marconicivitavecchia/2024-pedana-salto/ads1256.md

>[Torna all'indice](readme.md#fasi-progetto)

# Guida Collegamento ADS1256 con ESP32

## Hardware

### Modulo ADS1256
Il modulo utilizzato è un ADC (Analog to Digital Converter) ADS1256 con le seguenti caratteristiche:
- 24-bit di risoluzione
- 8 canali analogici
- Fino a 30kSPS di sampling rate
- Level shifter 5V-3.3V integrato
- Range di input analogico: ±5V (con alimentazione 5V)

### Collegamenti

#### Pin ESP32 → Modulo ADS1256
| ESP32 Pin | ADS1256 Pin | Descrizione |
|---|---|---|
| GPIO18 | SCLK | Clock SPI |
| GPIO23 | DIN | Data In (MOSI) |
| GPIO19 | DOUT | Data Out (MISO) |
| GPIO5* | CS | Chip Select |
| GPIO4* | DRDY | Data Ready |
| 3.3V | VDD | Alimentazione |
| GND | GND | Ground |

\* Questi pin possono essere cambiati con altri GPIO disponibili 

#### Pin Opzionali
- RESET: Non necessario, ha pull-up interno
- PDWN: Non necessario, ha pull-up interno

### Note Importanti
1. **Alimentazione**
   - Il modulo può essere alimentato sia a 5V che a 3.3V
   - Con alimentazione a 5V si ha il massimo range di input analogico (±5V)
   - Con alimentazione a 3.3V il range di input si riduce proporzionalmente

2. **Level Shifting**
   - Il modulo include già la conversione di livello 5V-3.3V
   - Non sono necessari convertitori di livello aggiuntivi
   - I segnali digitali sono già compatibili con la logica 3.3V dell'ESP32

3. **Ground**
   - Per le migliori prestazioni, mantenere separati i ground analogici e digitali
   - Collegare entrambi in un unico punto vicino all'alimentazione

4. **Input Analogici**
   - AIN0-AIN7: Accettano tensioni nel range ±5V (con VDD=5V)
   - Impedenza di ingresso: >1MΩ
   - Protezione da sovratensioni integrata

## Configurazione Software

### Inizializzazione SPI
```cpp
// Definizione pin
#define ADS1256_DRDY_PIN 4
#define ADS1256_CS_PIN   5

// Configurazione SPI
SPIClass *spi = new SPIClass(VSPI);
spi->begin(18, 19, 23, 5); // SCLK, MISO, MOSI, SS

// Configurazione pin
pinMode(ADS1256_DRDY_PIN, INPUT);
pinMode(ADS1256_CS_PIN, OUTPUT);
digitalWrite(ADS1256_CS_PIN, HIGH);
```

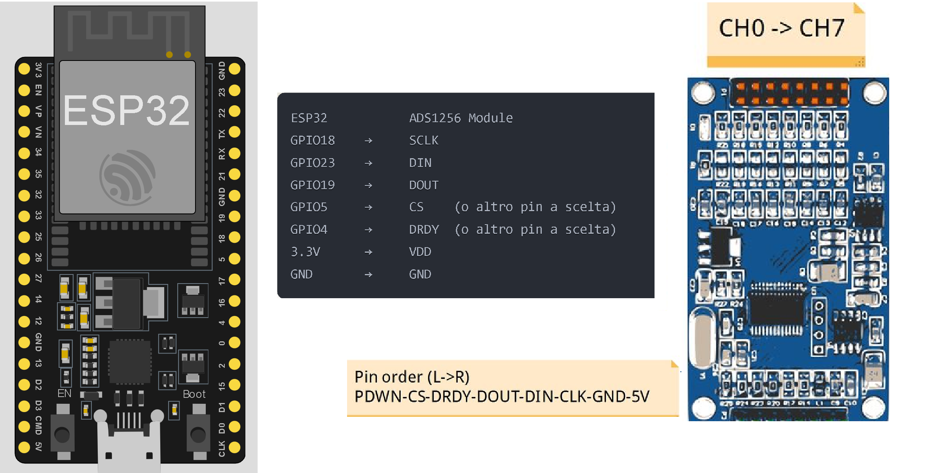
[picture p3: img/esp32pinout.png]


## Scheda Heltec WiFi_Kit_32_v3

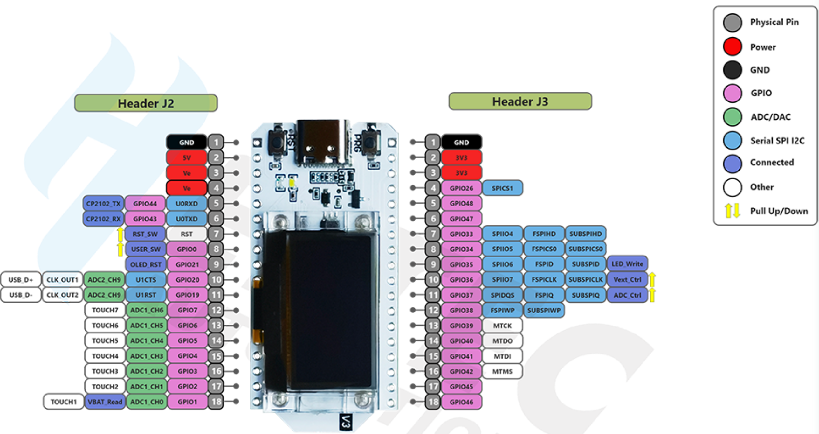
[picture p4: img/HTIT-WB32_V3.png]


### PINOUT ADS1256

| ADS1256 Pin | ESP32 Heltec V3 Pin | Funzione | Note |
|---|---|---|---|
| **Collegamenti SPI** ||||
| SCLK | GPIO47 (SPICLK_P)  | Clock SPI | *Collegamenti digitali* |
| DIN | GPIO35 (GPIO35) | Data Input (MOSI) | *Collegamenti digitali* |
| DOUT | GPIO36 (GPIO36) | Data Output (MISO) | *Collegamenti digitali* |
| CS | GPIO37 (GPIO37) | Chip Select | *Collegamenti digitali* |
| DRDY | GPIO38 (GPIO38) | Data Ready | *Collegamenti digitali* |
| **Collegamenti DAC -> ADC** ||||
| AIN6 | GPIO1 (DAC1) | Ingresso ADC+ canale diff. | *Segnale di test ADC* |
| AIN7 | GPIO2 (DAC2) | Ingresso ADC- canale diff. | *Segnale di test ADC* |
| **Alimentazioni** ||||
| AVDD | 3.3V (VDD_3V3) | Alimentazione Analogica | *Pin 2 o 3 di J3* |
| DVDD | 3.3V (VDD_3V3) | Alimentazione Digitale | *Pin 2 o 3 di J3* |
| PWDN | 3.3V (VDD_3V3) | Power Down (attivo basso) | *Pin 2 o 3 di J3* |
| **Masse** ||||
| AGND | GND centrale | Ground Analogico | *GND pad centrale vicino antenna* |
| DGND | GND (Pin 1 J2) | Ground Digitale | *Pin 1 del Header J2* |
| **Connessioni esterne** ||||
| AIN0 | - | Ingresso ADC+ canale diff. | *Connettore esterno doppino schermato* |
| AIN1 | - | Ingresso ADC- canale diff. | *Connettore esterno doppino schermato* |

Note aggiuntive:

- Il GND centrale (pad vicino antenna) è raccomandato per i segnali analogici poiché è più isolato dai disturbi digitali
- Il pin 1 di J2 è consigliato per i segnali digitali SPI dato che è più vicino ai pin di comunicazione
- Le alimentazioni 3.3V possono essere prese dai pin 2 o 3 del Header J3
- Si raccomanda di mantenere le piste di ground separate il più possibile sul PCB e unirle in un unico punto vicino all'alimentazione
- Aggiungere capacità di bypass tra AVDD-AGND e DVDD-DGND il più vicino possibile ai pin dell'ADS1256

### Pinout schermo OLED

| Pin Display | ESP32 Heltec V3 Pin | Funzione |
|---|---|---|
| CS | GPIO39 (MTCK) | Chip Select OLED |
| DC | GPIO40 (MTDO) | Data/Command |
| RST | GPIO21 (GPIO21) | Reset |
| D0/SCK | GPIO41 (MTDI) | Clock SPI |
| D1/MOSI | GPIO42 (MTMS) | Data Input |

Lo schermo OLED usa l'interfaccia SPI secondaria attraverso i pin MT** (JTAG), che sono stati riproposti per questo scopo.

Questo è separato dall'interfaccia SPI che abbiamo pianificato di usare per l'ADS1256, quindi non ci saranno conflitti tra i due dispositivi.

### Velocità SPI
- L'ADS1256 supporta clock SPI fino a 2MHz
- Consigliato iniziare con frequenze più basse (es. 1MHz) e aumentare se necessario
- La velocità può essere impostata con: `spi->beginTransaction(SPISettings(1000000, MSBFIRST, SPI_MODE1));`

## Troubleshooting
1. **Letture instabili**
   - Verificare la qualità dell'alimentazione
   - Controllare la connessione dei ground
   - Ridurre la velocità SPI

2. **Comunicazione non funzionante**
   - Verificare i collegamenti dei pin SPI
   - Controllare la tensione di alimentazione
   - Verificare che CS e DRDY funzionino correttamente

3. **Rumore nelle misure**
   - Utilizzare cavi schermati per gli input analogici
   - Separare i percorsi dei segnali analogici e digitali
   - Considerare l'uso di ferriti sui cavi di alimentazione

Il FW, completo di pagina web di interfaccia, è reperibile nella cartella src: https://github.com/marconicivitavecchia/2024-pedana-salto/tree/main/src

La libreria ```ADS1256_DMA.h``` in uso imposta già internamente sia le porte digitali che il BUS SPI secondo le pedinature sopra riportate per cui non è necessario eseguire la loro configurazione esplicita all'interno della funzione ```setup()```.

Sitografia:
- https://espressif-docs.readthedocs-hosted.com/projects/arduino-esp32/en/latest/api/timer.html
- https://claude.ai/chat/577f5692-3126-4db2-abea-41f3730c12e6

>[Torna all'indice](readme.md#fasi-progetto)
