marconicivitavecchia/2024-pedana-salto/img/ads1256_single_ended.png

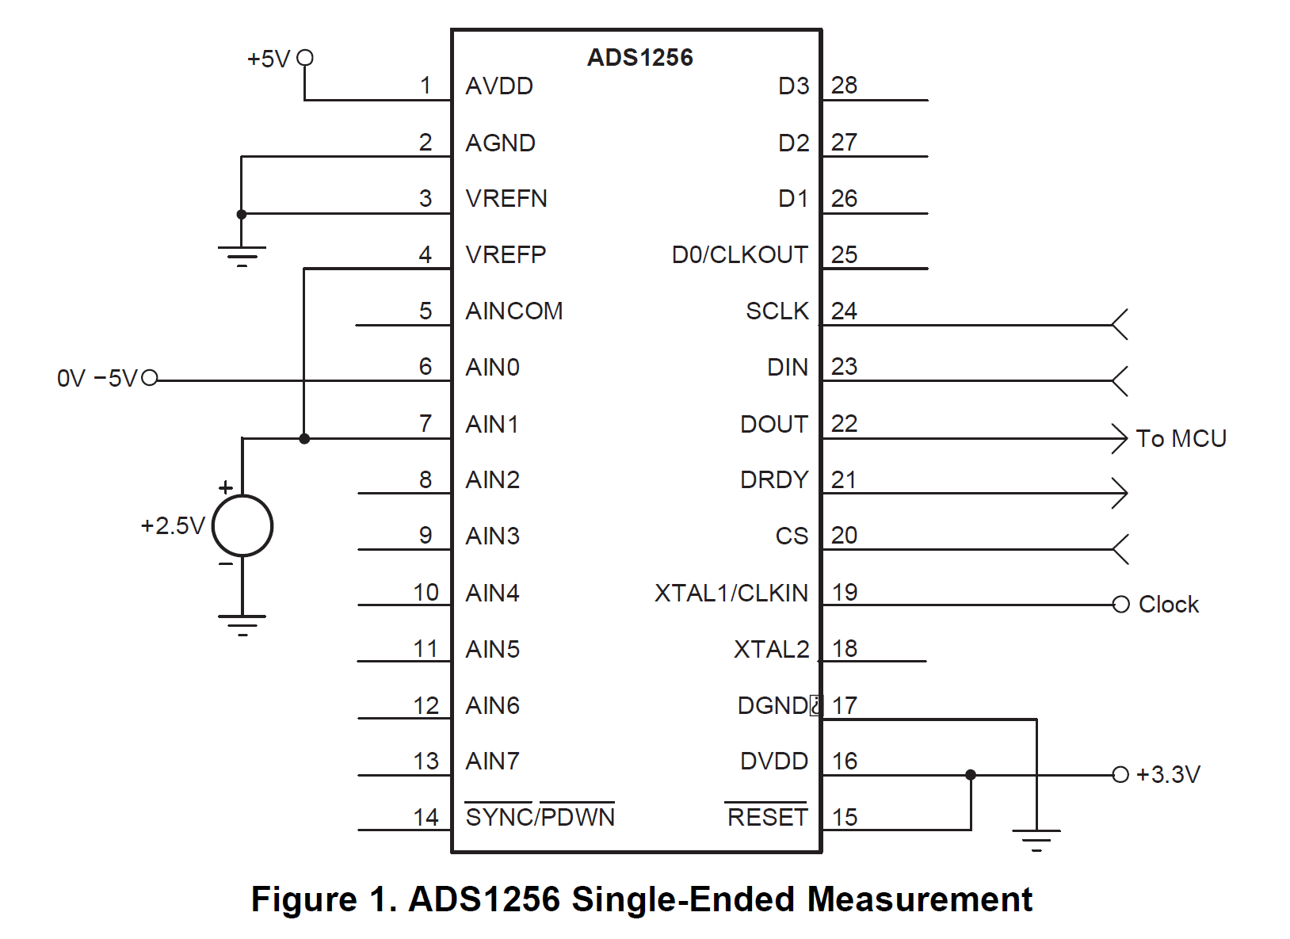
img/ads1256_single_ended.png
