marconicivitavecchia/2024-pedana-salto/img/prototipo/case2.jpg

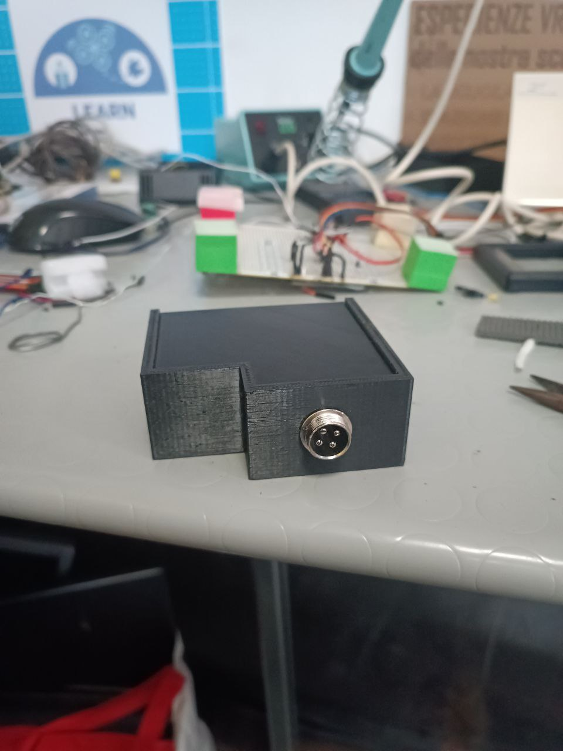
img/prototipo/case2.jpg
