marconicivitavecchia/2024-pedana-salto/img/prototipo/case.jpg

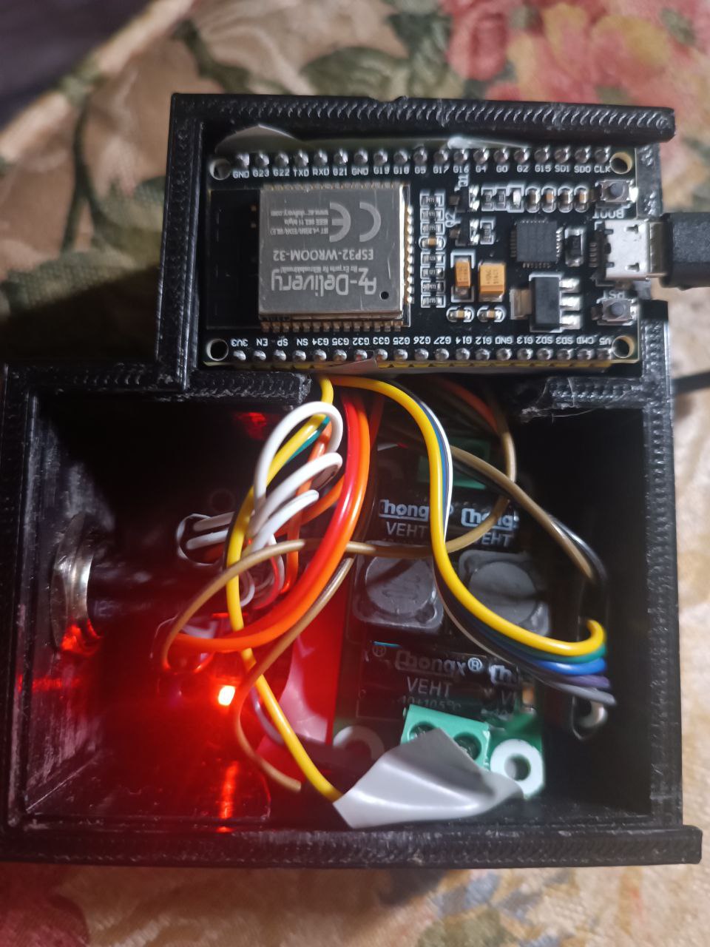
img/prototipo/case.jpg
