marconicivitavecchia/2024-pedana-salto/img/prototipo/dout.jpg

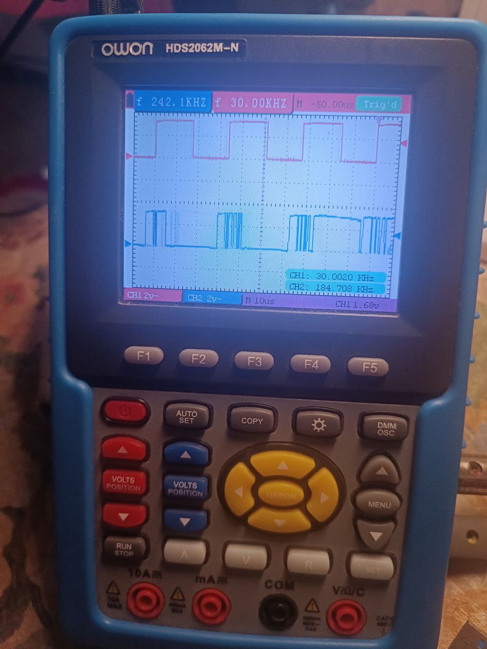
img/prototipo/dout.jpg
