marconicivitavecchia/2024-pedana-salto/img/unipolar_bridge.png

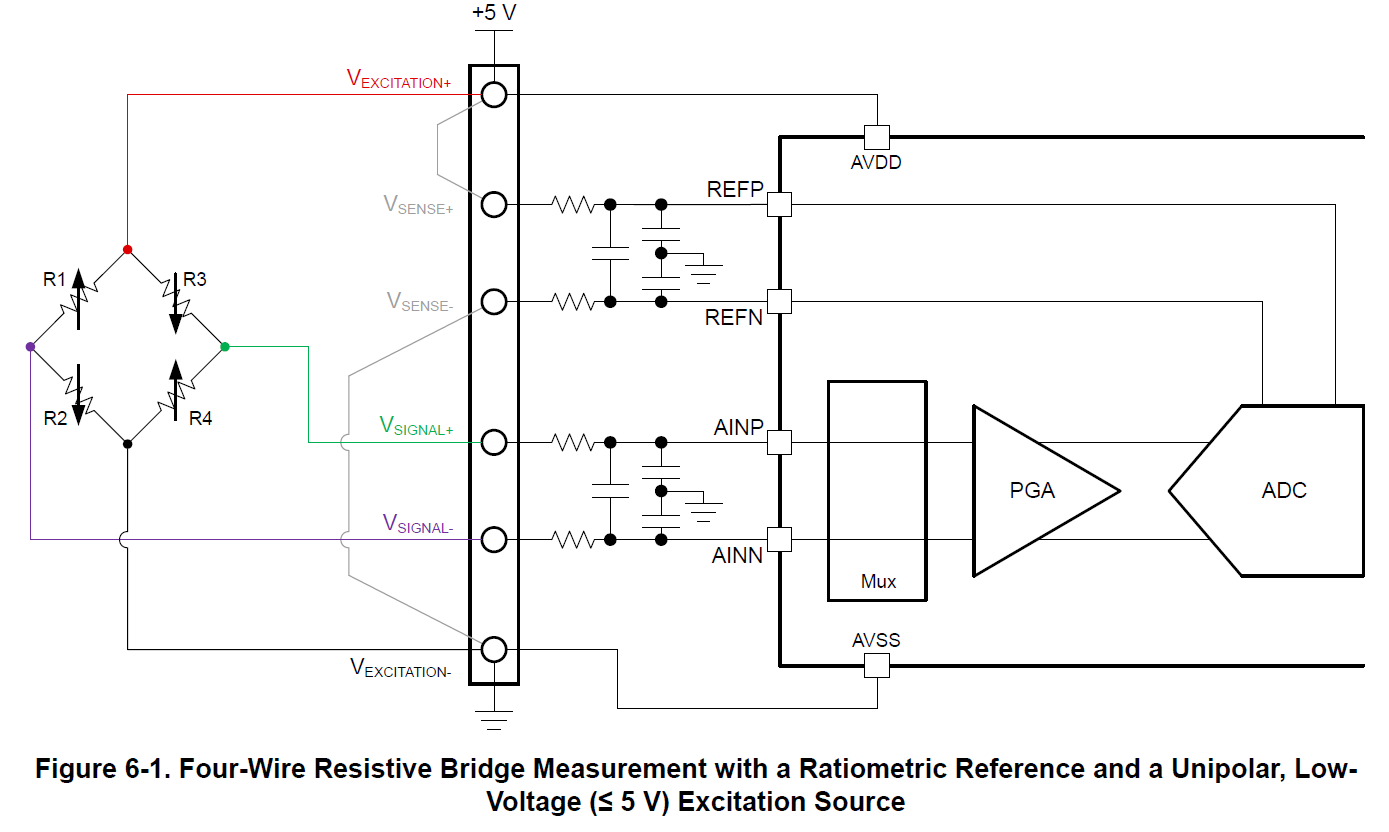
img/unipolar_bridge.png
