marconicivitavecchia/2024-pedana-salto/manuali/salti.pdf

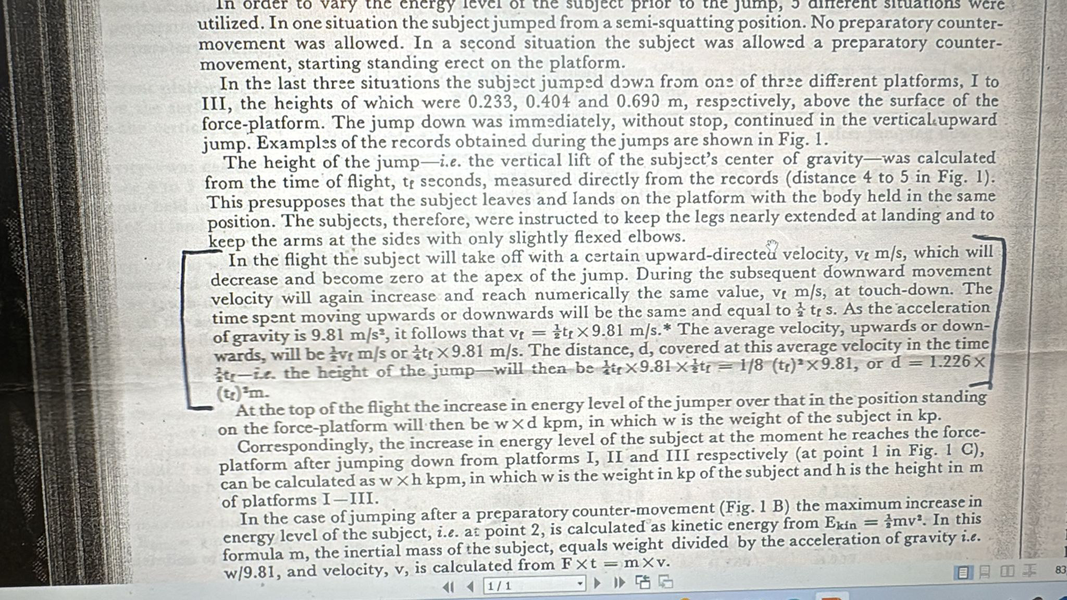
[picture p19: page 1]
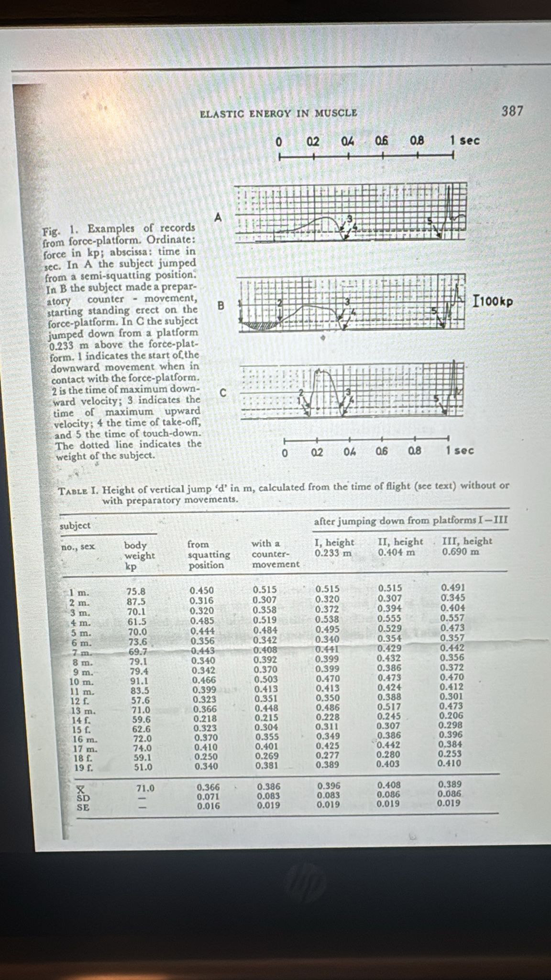
[picture p20: page 2]
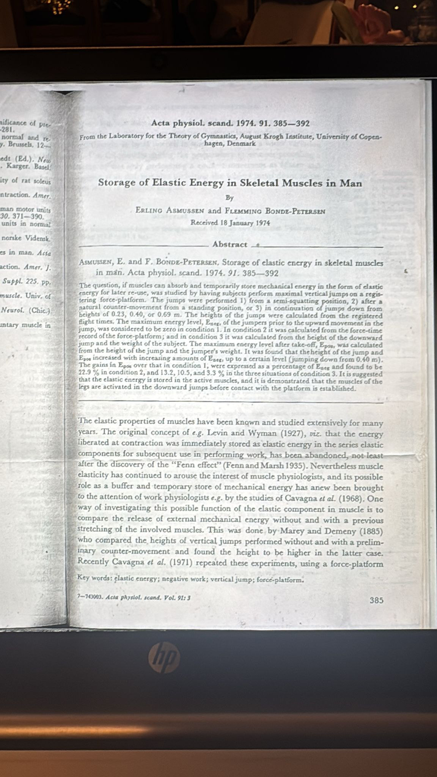
[picture p21: page 3]
