marconicivitavecchia/2024-pedana-salto/manuali/Guida CSS Flexbox_ Da Layout Verticale a Orizzontale.pdf

# 📐 Guida CSS Flexbox: Trasformazione da Layout Verticale a

# Orizzontale

## 🎯 Obiettivo

Trasformare due elementi che si trovano uno sotto l'altro in un layout affiancato, responsive e professionale.

## 📋 Situazione di Partenza

### HTML Originale

### CSS Originale

### Risultato Visivo

html
<div class="config-item">
<label>Current Configuration:</label>
<div id="currentConfig">Waiting for connection...</div> </div>

<div class="stats">
<div>Batch Stats:</div>
<div id="batchStats">No data yet</div> </div>

css
.config-item {
margin: 10px 0;
}

.stats {
margin: 10px 0;
padding: 10px;
background-color: #e0e0e0; }

## 🔄 Trasformazione con Flexbox

### 1. Nuovo HTML

### 2. Nuovo CSS

┌─────────────────────────────────┐
│ Current Configuration: | │
│ Sample Rate: 30000 Hz | │
│ EMA Alpha: 0.10 | │
└─────────────────────────────────┘

┌─────────────────────────────────┐
│ Batch Stats: | │
│ Received Batches: 1250 | │
│ Avg Interval: 5.02 ms | │
└─────────────────────────────────┘

html
<div class="flex-container">
<div class="flex-item">
<label><strong>Current Configuration:</strong></label> <div id="currentConfig">Waiting for connection...</div> </div>

<div class="flex-item">
<label><strong>Batch Stats:</strong></label>
<div id="batchStats">No data yet</div> </div>
</div>

### 3. Risultato Visivo

## 🧰 Anatomia di Flexbox

### Container Flexbox (Genitore)

css
.flex-container {
display: flex; | /* 🔑 Abilita Flexbox */
gap: 20px; | /* 📏 Spazio tra elementi */
margin: 10px 0; | /* 📐 Margini esterni */

}

.flex-item {

flex: 1; | /* 🎯 Distribuzione uguale dello spazio */
padding: 10px; | /* 📦 Padding interno */
background-color: #e0e0e0;
border-radius: 5px; /* 🎨 Angoli arrotondati */

}

/* 📱 Responsive Design */
@media (max-width: 768px) {
.flex-container {
flex-direction: column; /* 📱 Colonna su mobile */ }
}

┌───────────────────┐ gap ┌──────────────────┐
│ Current Config: │ 20px │ Batch Stats: │
│ Sample Rate: 30k │ │ Batches: 1250 │
│ EMA Alpha: 0.10 │ │ Interval: 5.02ms │
│ Streaming: Active │ │ Rate: 199.2 Hz │
└───────────────────┘ └──────────────────┘

css
.flex-container {
display: flex; | /* Abilita Flexbox */
flex-direction: row; | /* row | column | row-reverse | column-reverse */
justify-content: flex-start; /* Allineamento orizzontale */
align-items: stretch; | /* Allineamento verticale */
gap: 20px; | /* Spazio tra elementi */
flex-wrap: nowrap; | /* wrap | nowrap | wrap-reverse */
}

### Elementi Flex (Figli)

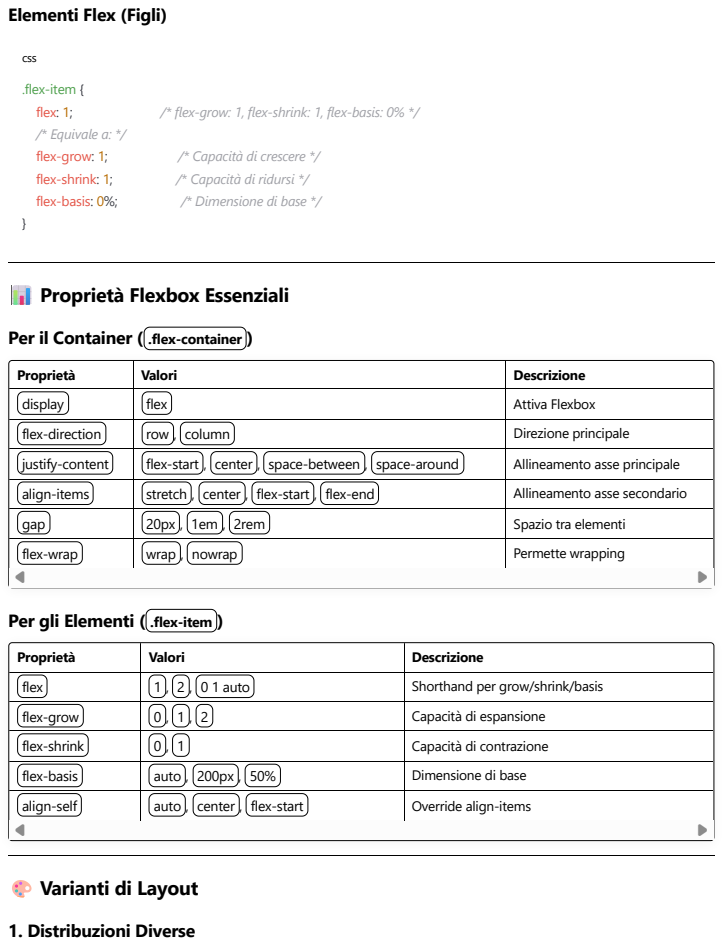
[picture p22: page 4]
Proprietà; Valori; Descrizione; display; flex; Attiva Flexbox; flex-direction; row , column; Direzione principale; justify-content; flex-start , center , space-between , space-around; Allineamento asse principale; align-items; stretch , center , flex-start , flex-end; Allineamento asse secondario; gap; 20px , 1em , 2rem; Spazio tra elementi; flex-wrap; wrap , nowrap; Permette wrapping; 1 , 2 , 0 1 auto; Shorthand per grow/shrink/basis; flex-grow; Capacità di espansione; flex-shrink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

.flex-item {
/* Equivale a: */
📊 Proprietà Flexbox Essenziali

Per il Container ( .flex-container )

Per gli Elementi ( .flex-item )

🎨 Varianti di Layout

### 2. Larghezza Fissa + Flessibile

### 3. Centratura Verticale

## 📱 Responsive Design

### Breakpoints Comuni

/* Primo elemento più largo */ .flex-item:first-child {
flex: 2; /* Occupa 2/3 dello spazio */ }
.flex-item:last-child {
flex: 1; /* Occupa 1/3 dello spazio */ }

css
.flex-item:first-child {
flex: 0 0 300px; /* Larghezza fissa 300px */ }
.flex-item:last-child {
flex: 1; /* Occupa spazio rimanente */ }

css
.flex-container {
align-items: center; /* Centra verticalmente */
min-height: 100px; /* Altezza minima per vedere l'effetto */ }

## 🔧 Debugging Flexbox

### Strumenti Utili

1. Browser DevTools: Ispeziona elemento → Tab "Flexbox"
2. Outline temporaneo:

### Problemi Comuni e Soluzioni

/* Desktop */
.flex-container {
display: flex;
flex-direction: row;
}

/* Tablet */
@media (max-width: 1024px) { .flex-container {
gap: 15px;
}
}

/* Mobile */
@media (max-width: 768px) { .flex-container {
flex-direction: column;
gap: 10px;
}
}

/* Mobile piccolo */
@media (max-width: 480px) { .flex-item {
padding: 8px;
font-size: 14px;
}
}

css
.flex-container * {
outline: 1px solid red; /* Visualizza i bordi */ }

## 🌟 Vantaggi di Flexbox

### ✅ Pro

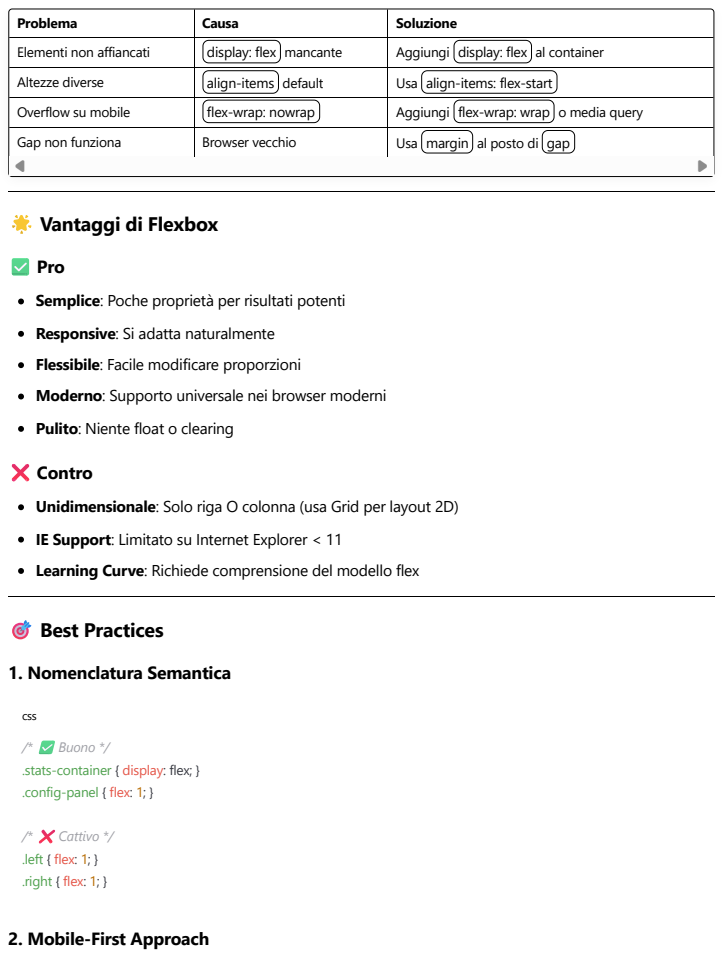
[picture p23: page 7]
Problema; Causa; Soluzione; Elementi non affiancati; display: flex mancante; Aggiungi display: flex al container; Altezze diverse; align-items default; Usa align-items: flex-start; Overflow su mobile; flex-wrap: nowrap; Aggiungi flex-wrap: wrap o media query; Gap non funziona; Browser vecchio; Usa margin al posto di gap; 🎯 Best Practices; 1. Nomenclatura Semantica; .left { flex: 1; } .right { flex: 1; }

Semplice: Poche proprietà per risultati potenti
Responsive: Si adatta naturalmente
Flessibile: Facile modificare proporzioni
Moderno: Supporto universale nei browser moderni
Pulito: Niente float o clearing
❌ Contro

Unidimensionale: Solo riga O colonna (usa Grid per layout 2D)
IE Support: Limitato su Internet Explorer < 11
Learning Curve: Richiede comprensione del modello flex

css
/* ✅ Buono */
.stats-container { display: flex; }
.config-panel { flex: 1; }
/* ❌ Cattivo */

2. Mobile-First Approach

### 3. Fallback per Browser Vecchi

## 📚 Risorse Aggiuntive

MDN Flexbox Guide: https://developer.mozilla.org/en-US/docs/Web/CSS/CSS_Flexible_Box_Layout CSS-Tricks Flexbox Guide: https://css-tricks.com/snippets/css/a-guide-to-flexbox/
Flexbox Froggy (gioco): https://flexboxfroggy.com/
Can I Use Flexbox: https://caniuse.com/flexbox

💡 Tip: Inizia sempre con display: flex e gap , poi aggiungi altre proprietà solo se necessario!

/* ✅ Mobile first */

.container { flex-direction: column; } @media (min-width: 768px) { .container { flex-direction: row; } }

css
/* Fallback per IE */
.flex-item {
width: 48%; /* Fallback */ display: inline-block; /* Fallback */ flex: 1; /* Flexbox */
}
