marconicivitavecchia/2024-pedana-salto/img/prototipo/test.jpg

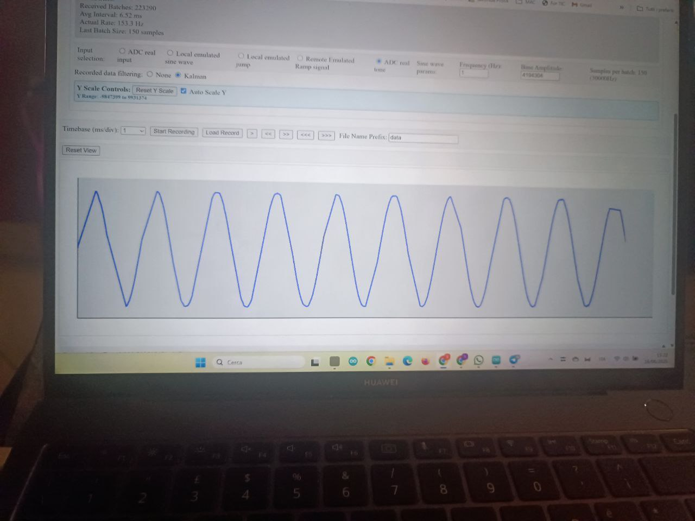
img/prototipo/test.jpg
