marconicivitavecchia/2024-pedana-salto/src/ADS1256_DMA.h

#ifndef ADS1256_DMA_H
#define ADS1256_DMA_H

#include "AdaptiveFIRFilter.h"

#include <driver/spi_master.h>
#include <driver/gpio.h>
#include <Arduino.h>
#include "esp_log.h"
#include "ADS1256_delays.h"

#include "soc/spi_struct.h"
#include "soc/spi_reg.h"
#include "soc/soc.h"

// Pin definitions
#define ADS1256_PIN_CS   21
#define ADS1256_PIN_DRDY 4
#define ADS1256_PIN_MISO 19 // DOUT
#define ADS1256_PIN_MOSI 23 // DIN
#define ADS1256_PIN_SCK  18

// ADS1256 Register definitions
#define ADS1256_REG_STATUS  0x00
#define ADS1256_REG_MUX     0x01
#define ADS1256_REG_ADCON   0x02
#define ADS1256_REG_DRATE   0x03
#define ADS1256_REG_IO      0x04
#define ADS1256_REG_OFC0    0x05
#define ADS1256_REG_OFC1    0x06
#define ADS1256_REG_OFC2    0x07
#define ADS1256_REG_FSC0    0x08
#define ADS1256_REG_FSC1    0x09
#define ADS1256_REG_FSC2    0x0A

// Commands
#define ADS1256_CMD_WAKEUP  0x00
#define ADS1256_CMD_RDATA   0x01
#define ADS1256_CMD_RDATAC  0x03
#define ADS1256_CMD_SDATAC  0x0F
#define ADS1256_CMD_RREG    0x10
#define ADS1256_CMD_WREG    0x50
#define ADS1256_CMD_SELFCAL 0xF0
#define ADS1256_CMD_SELFOCAL 0xF1
#define ADS1256_CMD_SELFGCAL 0xF2
#define ADS1256_CMD_SYSOCAL 0xF3
#define ADS1256_CMD_SYSGCAL 0xF4
#define ADS1256_CMD_SYNC    0xFC
#define ADS1256_CMD_STANDBY 0xFD
#define ADS1256_CMD_RESET   0xFE

#define MAX_SAMPLES_PER_BATCH 150u  // Aggiunto 'u' per unsigned

// Istanza globale del filtro
AdaptiveFIRFilter firFilter;

// Fuori dalla classe, nel file .cpp
static bool g_spi_native_configured = false;

enum ads1256_drate_t {
   ADS1256_DRATE_30000SPS = 0xF0,    // 30,000 SPS
   ADS1256_DRATE_15000SPS = 0xE0,    // 15,000 SPS
   ADS1256_DRATE_7500SPS  = 0xD0,    // 7,500 SPS
   ADS1256_DRATE_3750SPS  = 0xC0,    // 3,750 SPS
   ADS1256_DRATE_2000SPS  = 0xB0,    // 2,000 SPS
   ADS1256_DRATE_1000SPS  = 0xA0,    // 1,000 SPS ✅ Corretto
   ADS1256_DRATE_500SPS   = 0x90,    // 500 SPS ✅ Corretto
   ADS1256_DRATE_100SPS   = 0x80,    // 100 SPS ✅ Corretto
   ADS1256_DRATE_60SPS    = 0x70,    // 60 SPS ✅ Corretto
   ADS1256_DRATE_50SPS    = 0x60,    // 50 SPS ✅ Corretto
   ADS1256_DRATE_30SPS    = 0x50,    // 30 SPS ✅ Corretto
   ADS1256_DRATE_25SPS    = 0x40,    // 25 SPS ✅ Corretto
   ADS1256_DRATE_15SPS    = 0x30,    // 15 SPS ✅ Corretto
   ADS1256_DRATE_10SPS    = 0x20,    // 10 SPS ✅ Corretto
   ADS1256_DRATE_5SPS     = 0x10,    // 5 SPS ✅ Corretto
   ADS1256_DRATE_2_5SPS   = 0x00     // 2.5 SPS ✅ Corretto
};

// Chip settings
enum ads1256_channels_t {
    ADS1256_AIN0 = 0,
    ADS1256_AIN1 = 1,
    ADS1256_AIN2 = 2,
    ADS1256_AIN3 = 3,
    ADS1256_AIN4 = 4,
    ADS1256_AIN5 = 5,
    ADS1256_AIN6 = 6,
    ADS1256_AIN7 = 7,
    ADS1256_AINCOM = 8
};

enum ads1256_gain_t {
    ADS1256_GAIN_1 = 0,   
    ADS1256_GAIN_2 = 1,   
    ADS1256_GAIN_4 = 2,   
    ADS1256_GAIN_8 = 3,   
    ADS1256_GAIN_16 = 4,  
    ADS1256_GAIN_32 = 5,  
    ADS1256_GAIN_64 = 6   
};

// Struttura per il batch di campioni
struct BatchData {
    uint32_t t;
    uint8_t count;
    uint8_t v[MAX_SAMPLES_PER_BATCH][3];  // 3 bytes per valore
};
/*
// Versione ottimizzata per memoria
struct __attribute__((packed)) BatchData {
    uint32_t timestamp;
    uint8_t count;
    uint8_t values[MAX_SAMPLES_PER_BATCH][3];
} BatchData;  // Elimina padding
*/
struct ADS1256Status {
   uint8_t status;      // STATUS register
   uint8_t mux;         // MUX register
   uint8_t adcon;       // ADCON register 
   uint8_t drate;       // DRATE register
   bool rdatac_active;  // True se in RDATAC
   bool chip_active;    // True se chip risponde
};

// Primo: definire i possibili codici di errore
enum class ADS1256_Error {
    NO_ERROR = 0,
    SPI_INIT_FAILED,
    CALIBRATION_TIMEOUT,
    CALIBRATION_FAILED,
    INVALID_CHANNEL,
    INVALID_GAIN,
    COMMUNICATION_ERROR,
    BUS_ACQUISITION_FAILED,
    DRDY_TIMEOUT,
    INVALID_REGISTER,
    BUFFER_OVERFLOW,
    INVALID_RATE,
    INVALID_DATA_RATE
};

// Secondo: aggiungere una classe per la gestione degli errori
class ADS1256_ErrorHandler {
private:
    ADS1256_Error lastError;
    char errorMessage[100];
	//uint32_t targetInterval;
	
    
public:
    ADS1256_ErrorHandler() : lastError(ADS1256_Error::NO_ERROR) {
        errorMessage[0] = '\0';
    }
    
    void setError(ADS1256_Error error, const char* message) {
        lastError = error;
        strncpy(errorMessage, message, sizeof(errorMessage) - 1);
        errorMessage[sizeof(errorMessage) - 1] = '\0';
        
        // Log dell'errore
        if(error != ADS1256_Error::NO_ERROR) {
            Serial.printf("ADS1256 Error: %s\n", message);
        }
    }
    
    ADS1256_Error getLastError() const { return lastError; }
    const char* getErrorMessage() const { return errorMessage; }
    void clearError() { 
        lastError = ADS1256_Error::NO_ERROR; 
        errorMessage[0] = '\0';
    }
};


class ADS1256_DMA {
public:

    ADS1256_DMA() : emaFilteredValue(0.0f) {
        Serial.println("Costruttore: inizio");
        //if (spi_bus_mutex == nullptr) {
        //    spi_bus_mutex = xSemaphoreCreateRecursiveMutex();
        //}     
        // CS come output, inizialmente alto
        pinMode(ADS1256_PIN_CS, OUTPUT);
        digitalWrite(ADS1256_PIN_CS, HIGH);
        pinMode(ADS1256_PIN_DRDY, INPUT);  // Input semplice senza pull-up
        pinMode(ADS1256_PIN_MISO, INPUT);       // MISO (input da ADS1256)
        pinMode(ADS1256_PIN_MOSI, OUTPUT);      // MOSI (output verso ADS1256)
        pinMode(ADS1256_PIN_SCK, OUTPUT);       // SCLK (clock generato da ESP32)  
		//targetInterval = 5000;
    }
	
    bool begin(){
		// Inizializza la lookup table UNA VOLTA all'avvio
		if (!init_hex_lookup_table_safe()) {
			Serial.println("ERRORE: Impossibile inizializzare hex lookup table!");
			return false;
		}
		
		// Verifica opzionale
		if (!verify_hex_lookup_table()) {
			Serial.println("ERRORE: Hex lookup table corrotta!");
			return false;
		}
		
        // Setup SPI configuration
        spi_bus_config_t buscfg;
        memset(&buscfg, 0, sizeof(spi_bus_config_t));
            
        buscfg.mosi_io_num = ADS1256_PIN_MOSI;
        buscfg.miso_io_num = ADS1256_PIN_MISO;
        buscfg.sclk_io_num = ADS1256_PIN_SCK;
        buscfg.quadwp_io_num = -1;
        buscfg.quadhd_io_num = -1;
        buscfg.max_transfer_sz = 32;
        buscfg.flags = 0;

        // Riconfigura SPI più lento
        spi_device_interface_config_t devcfg = {};
        devcfg.mode = 1;                    // CPOL=0, CPHA=1
        devcfg.clock_speed_hz = 1920000;     // Ridotto a 100kHz per debug
        devcfg.spics_io_num = -1;           // CS manuale
        devcfg.queue_size = 8;

        devcfg.command_bits = 0;
        devcfg.address_bits = 0;
        devcfg.dummy_bits = 0;
        devcfg.duty_cycle_pos = 128;        // Default duty cycle
        devcfg.cs_ena_pretrans = 0;
        devcfg.cs_ena_posttrans = 0;
        devcfg.pre_cb = NULL;
        devcfg.post_cb = NULL;

        if (!spi_initialized) {
            Serial.println("ADS1256_DMA: inizializzo SPI bus...");
            
            esp_err_t ret = spi_bus_initialize(SPI2_HOST, &buscfg, 1);
            if (ret != ESP_OK) {
                Serial.print("ADS1256_DMA: Errore nell'inizializzazione del bus SPI: ");
                Serial.println(esp_err_to_name(ret));  // Converte l'errore in una stringa leggibile
                //return false;  // Esci dalla funzione in caso di errore
            }
            Serial.println("ADS1256_DMA: SPI bus inizializzato");

            Serial.println("ADS1256_DMA: aggiungo device SPI...");
            ret = spi_bus_add_device(SPI2_HOST, &devcfg, &spi);
            if (ret != ESP_OK) {
                Serial.print("Errore nell'aggiunta del device SPI: ");
                Serial.println(esp_err_to_name(ret));
                return false;  // Esci dalla funzione in caso di errore
            }
            Serial.println("ADS1256_DMA: device SPI aggiunto");
        
            // update static flag
            spi_initialized = true;
        }   

        esp_err_t ret = spi_device_acquire_bus(spi, portMAX_DELAY);
        delay(50);
        if(ret == ESP_OK) {
            Serial.println("ADS1256_DMA: Bus SPI acquisito, inizializzo ADS1256...");
            spi_device_release_bus(spi);
            delay(50);			
            init_ads1256();
        }else{
            Serial.println("ADS1256_DMA: BUS non acquisito");
            //return false;
        }   
        return true; 
    }

    bool init_ads1256() {
        if (!spi_initialized) return false;
        
        // Hard reset
        sendCommand(ADS1256_CMD_RESET);
        T11Delay();  // 25ms delay dopo reset
        
        //waitDRDY();

        // Stop continuous mode
        sendCommand(ADS1256_CMD_SDATAC);
        
        // Setup registri base
        if(!writeRegister(ADS1256_REG_STATUS, 0x04)) {   // Buffer OFF, no auto-cal
            Serial.println("init_ads1256: Timeout durante set status");
        }
        
        if(!set_sample_rate(ADS1256_DRATE_30000SPS)) {    // 30000 SPS
            Serial.println("init_ads1256: Timeout durante set speed");
        }
        
        if(!set_single_channel(ADS1256_AIN1)) {      // AIN0 vs AINCOM
            Serial.println("init_ads1256: Timeout durante set single mode");
        }
        
        if(!set_gain(ADS1256_GAIN_1)) {
            Serial.println("init_ads1256: Timeout durante set initial gain 1");
        }
        
        // Avvio calibrazione
        sendCommand(ADS1256_CMD_SELFCAL);
        
        // Attendi completamento calibrazione con timeout
        if(!waitDRDY(10000)) {
            Serial.println("init_ads1256: Timeout durante la calibrazione");
            //return false;
        }
        
        // Verifica status register per conferma calibrazione
        uint8_t status = readRegister(ADS1256_REG_STATUS);
        if(status & 0x01) { // Bit 0 = Order Status Bit
            Serial.println("init_ads1256: Calibrazione fallita - Status check");
            //return false;
        }
        
        Serial.println("ADS1256_DMA: Inizializzazione ADS1256 completata con successo");
        return true;
    }

    ~ADS1256_DMA() {
        if(isStreaming) {
            stopStreaming();  // Questo rilascia il bus se era acquisito
        }
        
        if(spi) {
            spi_bus_remove_device(spi);
            spi_bus_free(SPI2_HOST);
        }
    }

    // Metodi pubblici per accedere agli errori
    ADS1256_Error getLastError() const { 
        return errorHandler.getLastError(); 
    }
    
    const char* getErrorMessage() const { 
        return errorHandler.getErrorMessage(); 
    }
    
    void clearErrors() { 
        errorHandler.clearError(); 
    }

    /* read_data_batch
    ---------------------------------------
        TEST SIGNAL GNERATION SECTION
    ---------------------------------------
    */
    
    uint32_t readCurrData() {
        uint32_t data = read_data();
        return data;
    }

    int32_t read_data() {
        waitDRDY();
        
        sendCommand(ADS1256_CMD_RDATA);
        T6Delay();

        CSON();
        T2Delay();

        uint8_t data[3];
        spi_transaction_t t2 = {};
        t2.length = 24;
        t2.rx_buffer = data;
        esp_err_t ret = spi_device_transmit(spi, &t2);

        T3Delay();
        CSOFF();

        if(ret != ESP_OK) {
            errorHandler.setError(ADS1256_Error::COMMUNICATION_ERROR,
                "Data read failed");
            return 0;
        }

        int32_t value = ((int32_t)data[0] << 16) |
                        ((int32_t)data[1] << 8)  |
                        (int32_t)data[2];

        if(value & 0x800000) {
            value |= 0xFF000000;
        }

        return value + offset;
    }  

	void configureSPINativeComplete() {
		spi_dev_t* SPI_DEV = &SPI2;
    
		Serial.println("Configurando SPI come ESP-IDF interno...");
		
		// Reset completo -> non parte
		//SPI_DEV->user.val = 0;
		//SPI_DEV->user1.val = 0;
		//SPI_DEV->user2.val = 0;
		
		//SPI_DEV->ctrl.val = 0;
		//SPI_DEV->ctrl1.val = 0;
		//SPI_DEV->ctrl2.val = 0;
	
		// Configurazione base
		SPI_DEV->user.usr_miso = 1;
		SPI_DEV->user.usr_mosi = 0;
		//SPI_DEV->user.usr_command = 0;
		//SPI_DEV->user.usr_addr = 0;
		//SPI_DEV->user.usr_dummy = 0;

		// Clock (formula ESP-IDF)
		//SPI_DEV->clock.clk_equ_sysclk = 0;
		//SPI_DEV->clock.clkdiv_pre = 0;
		//SPI_DEV->clock.clkcnt_n = 41;
		//SPI_DEV->clock.clkcnt_h = 20;
		//SPI_DEV->clock.clkcnt_l = 41;
		
		// SPI Mode 1 -> Segnale brutto
		//SPI_DEV->user.ck_out_edge = 0;
		//SPI_DEV->ctrl.wr_bit_order = 0;
		//SPI_DEV->ctrl.rd_bit_order = 0;
		
		// 24-bit
		SPI_DEV->miso_dlen.usr_miso_dbitlen = 23;
		SPI_DEV->mosi_dlen.usr_mosi_dbitlen = 0;
			
		// No DMA
		//SPI_DEV->dma_conf.val = 0;
		//SPI_DEV->dma_out_link.val = 0;
		//SPI_DEV->dma_in_link.val = 0;	
					
		// Clear flags e buffer -> non parte
		//SPI_DEV->slave.trans_done = 0;
		//SPI_DEV->slave.val = 0;
		
		//for (int i = 0; i < 16; i++) {
		//	SPI_DEV->data_buf[i] = 0;
		//}
		
		/*
		spi_dev_t* SPI_DEV = &SPI2;
		
		// Reset e configurazione finale
		SPI_DEV->user.val = 0;
		SPI_DEV->user1.val = 0;
		
		// Configurazione read-only 24-bit
		SPI_DEV->user.usr_miso = 1;               // ✅ Solo ricezione
		SPI_DEV->user.usr_mosi = 0;               // ✅ No trasmissione
		SPI_DEV->user.usr_command = 0;
		SPI_DEV->user.usr_addr = 0;
		SPI_DEV->user.usr_dummy = 0;
		
		// 24-bit transfer
		SPI_DEV->miso_dlen.usr_miso_dbitlen = 23; // 24-1
		SPI_DEV->mosi_dlen.usr_mosi_dbitlen = 0;  // Zero MOSI
		
		// Setup aggiuntivo
		SPI_DEV->ctrl.wr_bit_order = 0;           // MSB first
		SPI_DEV->ctrl.rd_bit_order = 0;           // MSB first
		
		// Buffer clean
		SPI_DEV->data_buf[0] = 0x00000000;
		*/
	}

	bool IRAM_ATTR wait_drdy_fast(uint32_t timeout_us = 1000) {
        uint32_t start = esp_timer_get_time();
        while (gpio_get_level((gpio_num_t)ADS1256_PIN_DRDY) && (esp_timer_get_time() - start) < timeout_us) {
            asm volatile("nop;");
        }
        return !gpio_get_level((gpio_num_t)ADS1256_PIN_DRDY);
    }
	
	bool IRAM_ATTR wait_drdy_fast2(uint32_t timeout_us = 1000) {
        uint32_t start = esp_timer_get_time();
        while (gpio_get_level((gpio_num_t)ADS1256_PIN_DRDY) && (esp_timer_get_time() - start) < timeout_us && esp_timer_get_time() > 30) {
            asm volatile("nop;");
        }
        return !gpio_get_level((gpio_num_t)ADS1256_PIN_DRDY);
    }
	
	void debugSPIConfiguration() {
		spi_dev_t* SPI_DEV = &SPI2;
		
		Serial.println("=== DEBUG CONFIGURAZIONE SPI ===");
		Serial.printf("USER register: 0x%08X\n", SPI_DEV->user.val);
		Serial.printf("  usr_miso: %d (1=abilitato)\n", SPI_DEV->user.usr_miso);
		Serial.printf("  usr_mosi: %d (0=disabilitato per read-only)\n", SPI_DEV->user.usr_mosi);
		Serial.printf("  usr_command: %d\n", SPI_DEV->user.usr_command);
		Serial.printf("  usr_addr: %d\n", SPI_DEV->user.usr_addr);
		Serial.printf("  usr_dummy: %d\n", SPI_DEV->user.usr_dummy);
		
		Serial.printf("MISO_DLEN: 0x%08X (%d bits)\n", 
					 SPI_DEV->miso_dlen.val, SPI_DEV->miso_dlen.usr_miso_dbitlen + 1);
		Serial.printf("MOSI_DLEN: 0x%08X (%d bits)\n", 
					 SPI_DEV->mosi_dlen.val, SPI_DEV->mosi_dlen.usr_mosi_dbitlen + 1);
		
		Serial.printf("CTRL register: 0x%08X\n", SPI_DEV->ctrl.val);
		Serial.printf("  wr_bit_order: %d (0=MSB first)\n", SPI_DEV->ctrl.wr_bit_order);
		Serial.printf("  rd_bit_order: %d (0=MSB first)\n", SPI_DEV->ctrl.rd_bit_order);
		
		Serial.printf("DATA_BUF[0]: 0x%08X\n", SPI_DEV->data_buf[0]);
		Serial.printf("CMD register: 0x%08X\n", SPI_DEV->cmd.val);
		
		Serial.println("==============================");
		
		// Verifica configurazione corretta per RDATAC
		bool configOK = true;
		
		if (SPI_DEV->user.usr_miso != 1) {
			Serial.println("❌ usr_miso dovrebbe essere 1");
			configOK = false;
		}
		
		if (SPI_DEV->user.usr_mosi != 0) {
			Serial.println("❌ usr_mosi dovrebbe essere 0 per read-only");
			configOK = false;
		}
		
		if (SPI_DEV->miso_dlen.usr_miso_dbitlen != 23) {
			Serial.printf("❌ miso_dbitlen dovrebbe essere 23 (24-bit), è %d\n", 
						 SPI_DEV->miso_dlen.usr_miso_dbitlen);
			configOK = false;
		}
		
		if (SPI_DEV->mosi_dlen.usr_mosi_dbitlen != 0) {
			Serial.printf("❌ mosi_dbitlen dovrebbe essere 0, è %d\n", 
						 SPI_DEV->mosi_dlen.usr_mosi_dbitlen);
			configOK = false;
		}
		
		if (configOK) {
			Serial.println("✅ Configurazione SPI corretta per RDATAC!");
		} else {
			Serial.println("⚠️ Configurazione SPI non ottimale!");
		}
	}
	
	void resetFIRFilter() {
		firFilter.reset();
	}
	
	void setDecimationFactor(uint16_t decimationFactor) {
		firFilter.reset();
		firFilter.setDecimationFactor(decimationFactor);
	}	

	// ========== VERSIONE ALTERNATIVA CON OTTIMIZZAZIONI MANUALI ==========
	// Se preferisci controllo granulare, puoi abilitare singole ottimizzazioni

	#define ENABLE_REGISTER_OPT     1
	#define ENABLE_BRANCH_ELIM      1  
	#define ENABLE_WORD_COPY        1
	#define ENABLE_TIMESTAMP_OPT    1

	int read_data_json_fir(char* jsonBuf, int maxJsonLen, uint16_t samplesPerBatch, uint16_t decimationFactor = 1) {
		if (!isStreaming || !jsonBuf) return -1;
		
		// Variabili con/senza register
		#if ENABLE_REGISTER_OPT
			register float targetSampleRate = 30000.0f / decimationFactor;
			register uint64_t timestamp = esp_timer_get_time();
			register uint16_t sampleCount = 0;
			register char* p = jsonBuf;
			register char* buf_end = jsonBuf + maxJsonLen;
		#else
			float targetSampleRate = 30000.0f / decimationFactor;
			uint64_t timestamp = esp_timer_get_time();
			uint16_t sampleCount = 0;
			char* p = jsonBuf;
			char* buf_end = jsonBuf + maxJsonLen;
		#endif
		
		// Header
		static const char header_start[] = "{\"t\":\"";
		memcpy(p, header_start, 6);
		p += 6;
		
		// Timestamp con/senza ottimizzazioni
		#if ENABLE_TIMESTAMP_OPT && ENABLE_BRANCH_ELIM
			// Versione ottimizzata branchless
			uint8_t adaptiveNibbles = 6 + (timestamp >= 0xFFFFFF) * 4 + (timestamp >= 0xFFFFFFFFF) * 3;
			static const uint64_t masks[3] = {0xFFFFFF, 0xFFFFFFFFFF, 0xFFFFFFFFFFFFF};
			uint8_t mask_index = (timestamp >= 0xFFFFFF) + (timestamp >= 0xFFFFFFFFF);
			uint64_t masked_timestamp = timestamp & masks[mask_index];
			
			static const char hex_chars[16] = {'0','1','2','3','4','5','6','7','8','9','a','b','c','d','e','f'};
			uint64_t temp = masked_timestamp;
			for (int i = adaptiveNibbles - 1; i >= 0; i--) {
				p[i] = hex_chars[temp & 0xF];
				temp >>= 4;
			}
			p += adaptiveNibbles;
		#else
			// Tuo codice originale
			uint8_t adaptiveNibbles;
			if (timestamp < 0xFFFFFF) {
				adaptiveNibbles = 6;
			} else if (timestamp < 0xFFFFFFFFF) {
				adaptiveNibbles = 10;
			} else {
				adaptiveNibbles = 13;
			}
			
			uint64_t masked_timestamp = timestamp & ((1ULL << (adaptiveNibbles * 4)) - 1);
			memset(p, '0', adaptiveNibbles);
			char* end_pos = p + adaptiveNibbles;
			uint64_t temp = masked_timestamp;
			int i = 0;
			while (temp > 0) {
				*(end_pos - 1 - i) = "0123456789abcdef"[temp & 0xF];
				temp >>= 4;
				i++;
			}
			p = end_pos;
		#endif
		
		// Middle header
		static const char header_middle[] = "\",\"v\":[";
		memcpy(p, header_middle, 7);
		p += 7;
		
		spi_dev_t* SPI_DEV = &SPI2;
		
		// Loop principale
		while (sampleCount < samplesPerBatch && 
			   sampleCount < MAX_SAMPLES_PER_BATCH && 
			   p < buf_end) {
			
			uint64_t accumulator = 0;
			
			for(uint16_t i = 0; i < decimationFactor; i++) {
				waitDRDY();
				T6Delay(); // risparmia molto tempo
				
				SPI_DEV->data_buf[0] = 0;
				SPI_DEV->cmd.usr = 1;
				while (SPI_DEV->cmd.usr);
				
				uint8_t rx_buffer[4];
				
				#if ENABLE_WORD_COPY
					*((uint32_t*)rx_buffer) = SPI_DEV->data_buf[0];  // Word copy
				#else
					memcpy(rx_buffer, (const void*)SPI_DEV->data_buf, 3);  // Tuo originale
				#endif
				
				uint32_t rawSample = (rx_buffer[0] << 16) | (rx_buffer[1] << 8) | rx_buffer[2];
				rawSample &= 0x00FFFFFF;
				
				uint32_t filteredSample;
				firFilter.processSample(rawSample, filteredSample);
				accumulator += (uint64_t)filteredSample;
			}
			
			uint32_t decimatedSample = (uint32_t)(accumulator / decimationFactor);
			
			// Separatore con/senza branch elimination
			#if ENABLE_BRANCH_ELIM
				*p = ',';
				p += (sampleCount > 0);
			#else
				if (sampleCount > 0) *p++ = ',';  // Tuo originale
			#endif
			
			*p++ = '"';
			
			// Hex conversion con/senza word copy
			uint8_t b0 = (decimatedSample >> 16) & 0xFF;
			uint8_t b1 = (decimatedSample >> 8) & 0xFF;
			uint8_t b2 = decimatedSample & 0xFF;
			
			#if ENABLE_WORD_COPY
				*((uint16_t*)p) = *((uint16_t*)&hex_table[b0][0]); p += 2;
				*((uint16_t*)p) = *((uint16_t*)&hex_table[b1][0]); p += 2;
				*((uint16_t*)p) = *((uint16_t*)&hex_table[b2][0]); p += 2;
			#else
				// Tuo originale
				*p++ = hex_table[b0][0]; *p++ = hex_table[b0][1];
				*p++ = hex_table[b1][0]; *p++ = hex_table[b1][1];
				*p++ = hex_table[b2][0]; *p++ = hex_table[b2][1];
			#endif
			
			*p++ = '"';
			sampleCount++;
		}
		
		// Footer
		static const char json_end[] = "]}";
		memcpy(p, json_end, 2);
		p += 2;
		*p = '\0';
		
		return p - jsonBuf;
	}


/*
    int read_data_json_fir(char* jsonBuf, int maxJsonLen, uint16_t samplesPerBatch, uint16_t decimationFactor = 1) {
		if (!isStreaming || !jsonBuf) return -1;
		
		// Pre-calcoli (ottimizzazione 5: register)
		register float targetSampleRate = 30000.0f / decimationFactor;
		register uint64_t timestamp = esp_timer_get_time();
		register uint16_t sampleCount = 0;
		
		// Ottimizzazione 5: Register optimization
		register char* p = jsonBuf;
		register char* buf_end = jsonBuf + maxJsonLen;
		register spi_dev_t* SPI_DEV = &SPI2;
		
		// ========== 2. WORD-ALIGNED MEMORY OPERATIONS ==========
		// Header JSON con memcpy sicuro (evita problemi endian)
		static const char JSON_HEADER_START[7] = "{\"t\":\"";
		memcpy(p, JSON_HEADER_START, 6);
		p += 6;
		
		// ========== TIMESTAMP CON ASM OTTIMIZZATO ==========
		// Ottimizzazione 3: Branch elimination per adaptive nibbles
		register uint8_t adaptiveNibbles = 6;
		adaptiveNibbles += ((timestamp >= 0xFFFFFF) << 2);      // +4 se >= 16.7 sec
		adaptiveNibbles += (timestamp >= 0xFFFFFFFFF) * 3;      // +3 se >= 4.6 ore
		
		// Maschera branchless
		static const uint64_t masks[3] = {0xFFFFFF, 0xFFFFFFFFFF, 0xFFFFFFFFFFFFF};
		register uint8_t mask_idx = (timestamp >= 0xFFFFFF) + (timestamp >= 0xFFFFFFFFF);
		register uint64_t masked_timestamp = timestamp & masks[mask_idx];
		
		// Usa ASM per conversione timestamp
		convert_timestamp_asm(masked_timestamp, p, adaptiveNibbles);
		p += adaptiveNibbles;
		
		// Middle header con memcpy sicuro
		static const char JSON_HEADER_MIDDLE[8] = "\",\"v\":[";
		memcpy(p, JSON_HEADER_MIDDLE, 7);
		p += 7;
		
		// ========== LOOP PRINCIPALE OTTIMIZZATO (SENZA UNROLLING) ==========
		// Pre-dichiarazioni per ottimizzazione register
		register uint64_t accumulator;
		register uint32_t rawSample, filteredSample, decimatedSample;
		uint8_t rx_buffer[4] __attribute__((aligned(4)));  // Buffer aligned per word copy
		
		while (sampleCount < samplesPerBatch && sampleCount < MAX_SAMPLES_PER_BATCH && p < buf_end) {
			
			accumulator = 0;
			
			for(register uint16_t i = 0; i < decimationFactor; i++) {
				waitDRDY(); T6Delay();
				
				SPI_DEV->data_buf[0] = 0;
				SPI_DEV->cmd.usr = 1;
				while (SPI_DEV->cmd.usr);
				
				*((uint32_t*)rx_buffer) = SPI_DEV->data_buf[0];  // Word copy
				
				rawSample = ((rx_buffer[0] << 16) | (rx_buffer[1] << 8) | rx_buffer[2]) & 0x00FFFFFF;
				
				firFilter.processSample(rawSample, filteredSample);
				accumulator += filteredSample;
			}
			
			decimatedSample = accumulator / decimationFactor;
			
			// ========== 3. BRANCH ELIMINATION + 2. WORD-ALIGNED ==========
			*p = ',';
			p += (sampleCount > 0);  // Branch elimination: avanza solo se necessario
			*p++ = '"';
			
			// ASM conversion ultra-veloce
			convert_hex_sample_asm(decimatedSample, p);
			p += 6;
			*p++ = '"';
			
			sampleCount++;
		}
		
		// ========== FOOTER CON MEMCPY SICURO ==========
		static const char JSON_FOOTER[3] = "]}";
		memcpy(p, JSON_FOOTER, 2);
		p += 2;
		*p = '\0';
		
		return p - jsonBuf;
	}
*/	
	void read_data_batch_fast(BatchData& batch, uint16_t samplesPerBatch, uint16_t decimationFactor = 1) {
		if (!isStreaming) return;
		
		batch.count = 0;
		batch.t = esp_timer_get_time();
		
		spi_dev_t* SPI_DEV = &SPI2;
		
		
		while (batch.count < samplesPerBatch && batch.count < MAX_SAMPLES_PER_BATCH) {
			uint64_t accumulator = 0;
			
			//float min_sample = 99999999, max_sample = 0;
			for(uint16_t i = 0; i < decimationFactor; i++) {
				while (gpio_get_level((gpio_num_t)ADS1256_PIN_DRDY));
				delayMicroseconds(1);
				
				SPI_DEV->data_buf[0] = 0;
				SPI_DEV->cmd.usr = 1;
				while (SPI_DEV->cmd.usr);
				
				// ✅ CAST VOLATILE per memcpy
				uint8_t rx_buffer[4];
				memcpy(rx_buffer, (const void*)SPI_DEV->data_buf, 3);
				
				uint32_t result = (rx_buffer[0] << 16) | (rx_buffer[1] << 8) | rx_buffer[2];
				result &= 0x00FFFFFF;  // Sicurezza aggiuntiva
				accumulator += (uint64_t) result;
				
			}
			
			accumulator = (uint64_t) accumulator / decimationFactor;
						
			emaFilteredValue = emaAlpha * (uint64_t)accumulator + (1 - emaAlpha) * emaFilteredValue;
			
			uint32_t output = (uint64_t)accumulator;
			
			batch.v[batch.count][0] = (output >> 16) & 0xFF;
			batch.v[batch.count][1] = (output >> 8) & 0xFF;
			batch.v[batch.count][2] = output & 0xFF;
			
			batch.count++;			
		}
	}
	
	void read_data_batch_api(BatchData& batch, uint16_t samplesPerBatch, uint16_t decimationFactor = 1) {
		if (!isStreaming) return;
		
		batch.count = 0;
		batch.t = esp_timer_get_time();
		
		// ✅ Pre-alloca transazione per efficienza
		spi_transaction_t trans = {};
		uint8_t rx_data[4];
		trans.length = 24;
		trans.rxlength = 24;
		trans.rx_buffer = rx_data;
		trans.tx_buffer = nullptr;
		trans.flags = 0;
		
		while (batch.count < samplesPerBatch && batch.count < MAX_SAMPLES_PER_BATCH) {
			// ✅ ESP-IDF style: aspetta solo DRDY LOW
			while (gpio_get_level((gpio_num_t)ADS1256_PIN_DRDY));
			delayMicroseconds(1);  // T6 delay
			
			// ✅ Trasferimento con API ESP-IDF
			esp_err_t ret = spi_device_polling_transmit(spi, &trans);
			
			if (ret == ESP_OK) {
				// Ricostruisci esattamente come versione nativa
				uint32_t result = (rx_data[0] << 16) | (rx_data[1] << 8) | rx_data[2];
				
				if (result != 0 && result != 0xFFFFFF) {
					if (result & 0x800000) result |= 0xFF000000;
					
					emaFilteredValue = emaAlpha * (float)result + (1.0f - emaAlpha) * emaFilteredValue;
					uint32_t output = (uint32_t)emaFilteredValue;
					
					batch.v[batch.count][0] = (output >> 16) & 0xFF;
					batch.v[batch.count][1] = (output >> 8) & 0xFF;
					batch.v[batch.count][2] = output & 0xFF;
					
					batch.count++;
				}
			} else {
				// Debug errori API
				Serial.printf("SPI API Error: %s\n", esp_err_to_name(ret));
			}
		}
	}

	void read_data_batch_fast2(BatchData& batch, uint16_t samplesPerBatch, uint16_t decimationFactor = 1) {
		if (!isStreaming) return;
		
		batch.count = 0;
		batch.t = esp_timer_get_time();
		
		spi_dev_t* SPI_DEV = &SPI2;  // Dichiarazione mancante!
				
		while (batch.count < samplesPerBatch && batch.count < MAX_SAMPLES_PER_BATCH) {
			// Attendi DRDY low
			if (!wait_drdy_fast2(5000)) {
				//Serial.printf("DRDY timeout al campione %d\n", batch.count);
				continue;
			}
			
			// Timing critico: piccolo delay dopo DRDY
			//__asm__ __volatile__ ("nop; nop; nop; nop;");  // ~83ns @ 240MHz
			
			// Timing critico dopo DRDY valido
            delayMicroseconds(1);  // T6 delay
			
			// Clear buffer e avvia transazione
			SPI_DEV->cmd.usr = 1;
			while (SPI_DEV->cmd.usr);
			
			uint32_t value = SPI_DEV->data_buf[0];
			
			#if __BYTE_ORDER__ == __ORDER_BIG_ENDIAN__
                    value >>= 8;  // Allinea i 24 bit se big endian
			#else
				value = __builtin_bswap32(value) >> 8;  // Swap e allinea se little endian
			#endif  

			// Se il dispositivo fornisce 24 bit, i bit più significativi (31-24) sono da ignorare
			value &= 0x00FFFFFF; // Mantieni solo i 24 bit meno significativi

			// Estensione del segno, se il dato è con segno (ADS1256 fornisce dati signed)
			if (value & 0x800000) {  // Se il bit 23 è 1 (numero negativo)
				value |= 0xFF000000; // Estendi il segno nei bit superiori
			}
			
			// Applica filtro EMA
			emaFilteredValue = emaAlpha * (float)((int32_t)value) + (1.0f - emaAlpha) * emaFilteredValue;
			uint32_t output = (uint32_t)emaFilteredValue;
			
			// Salva nel batch
			batch.v[batch.count][0] = (output >> 16) & 0xFF;
			batch.v[batch.count][1] = (output >> 8) & 0xFF;
			batch.v[batch.count][2] = output & 0xFF;
			
			batch.count++;
		}
	}

	void read_data_batch(BatchData& batch, uint16_t samplesPerBatch, uint16_t decimationFactor = 1) {
        // Inizializzazione semplice e compatibile
        spi_transaction_t trans = {};
        trans.length = 24;
        trans.rxlength = 24;
        trans.flags = 0;

        uint8_t rxdata[4];
        trans.rx_buffer = rxdata;


        batch.count = 0;
        batch.t = esp_timer_get_time();

        while(batch.count < samplesPerBatch) {
			if (!wait_drdy_fast(5000)) {
				//Serial.printf("DRDY timeout al campione %d\n", batch.count);
				continue;
			}
			
			// Timing critico: piccolo delay dopo DRDY
			__asm__ __volatile__ ("nop; nop; nop; nop;");  // ~83ns @ 240MHz

            spi_device_transmit(spi, &trans);  // Riusa la stessa struct

            uint32_t value = (rxdata[0] << 16) | (rxdata[1] << 8) | rxdata[2];
            if (value & 0x800000) value |= 0xFF000000;

            emaFilteredValue = emaAlpha * value + (1.0f - emaAlpha) * emaFilteredValue;
            uint32_t output = (uint32_t)emaFilteredValue;

            batch.v[batch.count][0] = output >> 16;
            batch.v[batch.count][1] = output >> 8;
            batch.v[batch.count][2] = output;

            batch.count++;
        }
    }

    void enableTestSignal(bool enable) {
        testSignalEnabled = enable;
        if (testSignalEnabled) {
            testSignalTime = 0;
        }
    }

    void forceOffset(uint32_t val) {
        offset = val;
    }

    void setTestSignalParams(float freq, float ampl, float amFreq) {
        testFrequency = freq;
        baseAmplitude = ampl;
        amFrequency = amFreq;
    }

    void generateTestSamples(BatchData& batch, uint16_t samplesPerBatch, uint16_t decimationFactor) {
        if (!testSignalEnabled) return;

        float signalPeriod = (float) decimationFactor / 30000;
        batch.count = 0;
        batch.t = esp_timer_get_time();
        float t = 1 / testFrequency;
        float amp = baseAmplitude;

        const float voltsToAdc = 8388608.0f / vRef;  // 2^23 / vRef
        
        // Incremento per ogni nuovo batch (esempio: incremento del 10% del range)
        rampValue += testFrequency*0.005f;
        // Usiamo rampValue invece della sinusoide
        float volts = rampValue * vRef;

        // Limitazione tensione
        if (volts < 0.0f) volts = 0.0f;
        //if (volts > vRef) rampValue = 0.0f;
        if (rampValue > 1.0f) rampValue = 0.0f;  // Reset quando raggiunge il massimo
        //batch.first =  (int32_t) (rampValue * 8388608.0f);
        //Serial.println(rampValue * 8388608.0f);
        //if (rampValue > 1.0f) rampValue = 0.0f;  // Reset quando raggiunge il massimo

        for (uint16_t i = 0; i < samplesPerBatch; i++) {
            
            int32_t value = (int32_t)(rampValue * amp);

            if (value < 0) {
                value += 0x1000000;
            }
            
            batch.v[i][0] = ((int32_t) value >> 16) & 0xFF;
            batch.v[i][1] = ((int32_t) value >> 8) & 0xFF;
            batch.v[i][2] = (int32_t) value & 0xFF;

            testSignalTime += signalPeriod;
            batch.count++;
        }
    }

    /* 
    ---------------------------------------
        REAL SIGNAL SAMPLING SECTION
    ---------------------------------------
    */
    float apply_ema(int32_t value) {
        emaFilteredValue = emaAlpha * value + (1.0f - emaAlpha) * emaFilteredValue;
        return emaFilteredValue;
    }  

   void startStreaming() {
		if (isStreaming || !spi_initialized) return;

		Serial.println("=== START STREAMING - CONFIG DOPO COMANDI ===");

		// 1. ✅ PRIMA: Tutti i comandi ADS1256 (che usano ESP-IDF)
		Serial.println("Fase 1: Comandi ADS1256 con ESP-IDF...");
		
		sendCommand(ADS1256_CMD_SDATAC);  // Stop continuous
		sendCommand(ADS1256_CMD_SYNC);    // Sync
		T3uDelay();
		sendCommand(ADS1256_CMD_WAKEUP);  // Wakeup
		T3uDelay();
		sendCommand(ADS1256_CMD_RDATAC);  // Start continuous
		
		configureSPINativeComplete();
		
		// 3. ✅ Setup CS per streaming continuo
		CSON();
		T2Delay();
		
		isStreaming = true;
		
		//Serial.println("✅ Streaming attivo con configurazione post-comandi!");
		
		// 4. Test immediato per verificare stabilità
		//Serial.println("Debug DOPO configurazione finale:");
		//debugSPIConfiguration();
		
		CSON();
		T2Delay();
		isStreaming = true;
		
		// Test semplice inline
		delay(10);
		//Serial.println("Configurazione dopo delay:");
		//debugSPIConfiguration();
		
		Serial.println("✅ Streaming attivo!");
	}

/*	
	void startStreaming() {
		if(isStreaming || !spi_initialized) return;
		
		// Prima attiva RDATAC
		sendCommand(ADS1256_CMD_RDATAC);
		delay(5);
		// ⚠️ CONFIGURA 24 BIT CON API IDF UNA VOLTA SOLA:
		Serial.println("Configurando SPI per 24 bit con API IDF...");
		
		uint8_t dummy_rx[4] = {0};
		spi_transaction_t config_trans = {};
		config_trans.length = 24;      // 24 bit totali
		config_trans.rxlength = 24;    // 24 bit ricezione
		config_trans.rx_buffer = dummy_rx;
		config_trans.tx_buffer = NULL;
		
		// Questa transazione configura i registri SPI3 per 24 bit
		esp_err_t ret = spi_device_transmit(spi, &config_trans);
		
		Serial.printf("Configurazione 24 bit: %s\n", esp_err_to_name(ret));
		
		// Verifica registri configurati
		Serial.printf("SPI3 configurato: user=0x%08X, miso_dlen=0x%08X\n", SPI3.user.val, SPI3.miso_dlen.val);
		
		isStreaming = true;
		CSON();
		T2Delay();
		
		Serial.println("Streaming attivo - registri pronti per uso diretto!");
	}
*/
    static void stopStreaming() {
        if(!isStreaming || !spi_initialized) return;
        // SDATAC è "fermati"
        sendCommand_static(ADS1256_CMD_SDATAC);  // Usa la versione statica
        CSOFF_static();
		T2Delay();  // se serve garantire chiusura pulita
        isStreaming = false;
    }

    // Versioni statiche per le funzioni statiche della classe
    static void CSON_static() {
        digitalWrite(ADS1256_PIN_CS, LOW);  // CS attivo basso
        //gpio_set_level((gpio_num_t)ADS1256_PIN_CS, 0);
        T2Delay();  // Delay dopo CS basso
    }

    static void CSOFF_static() {
        T3Delay();  // Delay prima di CS alto
        //gpio_set_level((gpio_num_t)ADS1256_PIN_CS, 1);
        digitalWrite(ADS1256_PIN_CS, HIGH); // CS inattivo alto
    }

    static void resetSPI() {
        Serial.println("resetSPI: inizio");
        
        if (!spi_initialized || spi == nullptr) {
            Serial.println("resetSPI: SPI non inizializzato o già resettato");
            return;
        }

        // 1. Prima fermiamo lo streaming se attivo
        stopStreaming();
        // 2. Aspettiamo che eventuali transazioni in corso si completino
        vTaskDelay(pdMS_TO_TICKS(100)); 

        // 3. Rimuoviamo il dispositivo SPI
        
        if(spi){
            //spi_device_release_bus(spi);
            Serial.println("resetSPI: removing device...");
            spi_bus_remove_device(spi);
            Serial.println("resetSPI: freeing device...");
            //if(xSemaphoreTakeRecursive(spi_bus_mutex, pdMS_TO_TICKS(1000)) == pdTRUE) {
            //spi_bus_free(SPI2_HOST);
            ////    xSemaphoreGiveRecursive(spi_bus_mutex);
            ////}
            spi = nullptr;
        }  
 
        // 5. Reset dei flag
        spi_initialized = false;
        isStreaming = false;
        
        Serial.println("resetSPI: completato");
    }

    bool set_sample_rate(ads1256_drate_t data_rate) {
        if(!spi_initialized) {
            errorHandler.setError(ADS1256_Error::SPI_INIT_FAILED, 
                "Set_sample_rate: SPI not initialized");
            return false;
        }

        // Verifica che il rate sia valido
        if (data_rate < ADS1256_DRATE_2_5SPS || data_rate > ADS1256_DRATE_30000SPS) {
            errorHandler.setError(ADS1256_Error::INVALID_RATE, 
                "Set_sample_rate: Invalid rate value");
            return false;
        }

        if(!writeRegister(ADS1256_REG_DRATE, static_cast<uint8_t>(data_rate))) {
            Serial.println("writeRegister fallita");
            return false;
        }

        sync();
        wakeup();
        
        return true;
    }

    bool set_single_channel(ads1256_channels_t channel) {
        return set_channel(channel, ADS1256_AINCOM);
    }

    void setEMAalfa(float alfa){
        emaAlpha = alfa;
    }

    bool set_channel(ads1256_channels_t positive_ch, ads1256_channels_t negative_ch = ADS1256_AINCOM) {
        if(!spi_initialized) {
            errorHandler.setError(ADS1256_Error::SPI_INIT_FAILED, 
                "Set_channel: SPI not initialized");
            return false;
        }
        if(positive_ch > ADS1256_AIN7 || negative_ch > ADS1256_AINCOM) {
            errorHandler.setError(ADS1256_Error::INVALID_CHANNEL, 
                "Set_channel: Invalid channel selection");
            return false;
        }
        /* 
        // Acquisizione condizionale del bus
        if(need_acquire) {
            esp_err_t ret = spi_device_acquire_bus(spi, portMAX_DELAY);
            if(ret != ESP_OK) return false;
        }
        */
        //CSON();
        uint8_t mux = (positive_ch << 4) | (negative_ch & 0x0F);
        writeRegister(ADS1256_REG_MUX, mux);
        sync();
        wakeup();
        CSOFF();

        /*
        // Rilascio condizionale del bus
        if(need_acquire) {
            spi_device_release_bus(spi);
        }
        */

        return true;
    }

    bool set_gain(ads1256_gain_t gain) {
        if(!spi_initialized) {
            errorHandler.setError(ADS1256_Error::SPI_INIT_FAILED, 
                "set_gain SPI not initialized");
            return false;
        }
        if(gain > ADS1256_GAIN_64) {
            errorHandler.setError(ADS1256_Error::INVALID_GAIN, 
                "set_gain Gain not valid");
            return false;
        }
        /* 
        // Acquisizione condizionale del bus
        if(need_acquire) {
            esp_err_t ret = spi_device_acquire_bus(spi, portMAX_DELAY);
            if(ret != ESP_OK) return false;
        }
        */

        //uint8_t adcon = 0x20 | gain;  // Clock Out OFF + gain
        //writeRegister(ADS1256_REG_ADCON, adcon);
        //sync();
        //TSettleDelay();
        //CSON();
        uint8_t bytemask = B00000111;           // maschera per i 3 bit del gain
        uint8_t adcon = readRegister(ADS1256_REG_ADCON);    // legge il valore attuale
        uint8_t byte2send = (adcon & ~bytemask) | gain;  // mantiene gli altri bit e imposta il gain
        writeRegister(ADS1256_REG_ADCON, byte2send);
        TSettleDelay();
        /*
        // Rilascio condizionale del bus
        if(need_acquire) {
            spi_device_release_bus(spi);
        }
        */

        return true;
    }


   void test_chip_active() {
        Serial.println("\nTest chip active dopo power up");
        
        // Reset
        sendCommand(ADS1256_CMD_RESET);
        
        // Leggi STATUS
        uint8_t status = readRegister(ADS1256_REG_STATUS);
        Serial.printf("STATUS dopo power up: 0x%02X\n", status);
    }

    ADS1256Status getDeviceStatus() {
        ADS1256Status status = {0};
        
        // Verifica PWDN pin

        // Test chip attivo provando a leggere STATUS
        status.status = readRegister(ADS1256_REG_STATUS);
        status.chip_active = (status.status != 0xFF && status.status != 0x00);
        
        //if(status.chip_active) {
            // Se chip attivo, legge altri registri
            status.mux = readRegister(ADS1256_REG_MUX);
            status.adcon = readRegister(ADS1256_REG_ADCON);
            status.drate = readRegister(ADS1256_REG_DRATE);
            status.rdatac_active = (status.status & 0x80);
        //}
        
        return status;
    }

    void printDeviceStatus(const ADS1256Status& status) {
        Serial.printf("\nADS1256 Device Status:\n");
        Serial.printf("Chip Active: %s\n", status.chip_active ? "YES" : "NO");
        Serial.printf("RDATAC Mode: %s\n", status.rdatac_active ? "ON" : "OFF");
        
        Serial.printf("\nRegisters:\n");
        Serial.printf("STATUS: 0x%02X\n", status.status);
        Serial.printf("MUX: 0x%02X\n", status.mux);
        Serial.printf("ADCON: 0x%02X\n", status.adcon);
        Serial.printf("DRATE: 0x%02X\n", status.drate);
    }
	
	//---------------------------------------------------------------------------------------------------------------------------------------------
	// ============================================================================
	// FUNZIONI DA COPIARE NELLA CLASSE ADS1256_DMA
	// ============================================================================

	// 1. FUNZIONE CONFRONTO FORMATI DATI
	void compareDataFormats() {
		Serial.println("=== CONFRONTO FORMATI DATI ===");
		
		if (!isStreaming) {
			Serial.println("Avvia streaming prima del test");
			return;
		}
		
		for (int i = 0; i < 5; i++) {
			Serial.printf("\n--- Confronto campione %d ---\n", i+1);
			
			// Attendi DRDY
			while (gpio_get_level((gpio_num_t)ADS1256_PIN_DRDY));
			
			// Metodo 1: API ESP-IDF (funzionante)
			spi_transaction_t trans = {};
			uint8_t rx_data[4] = {0};
			trans.length = 24;
			trans.rxlength = 24;
			trans.rx_buffer = rx_data;
			trans.tx_buffer = nullptr;
			
			esp_err_t ret = spi_device_polling_transmit(spi, &trans);
			
			uint32_t api_result = 0;
			if (ret == ESP_OK) {
				api_result = (rx_data[0] << 16) | (rx_data[1] << 8) | rx_data[2];
			}
			
			// Piccola pausa per prossimo campione
			delay(50);
			while (gpio_get_level((gpio_num_t)ADS1256_PIN_DRDY));
			
			// Metodo 2: Registri nativi (problematico)
			spi_dev_t* SPI_DEV = &SPI2;
			SPI_DEV->data_buf[0] = 0;
			SPI_DEV->cmd.usr = 1;
			while (SPI_DEV->cmd.usr);
			
			uint32_t native_raw = SPI_DEV->data_buf[0];
			uint32_t native_result = native_raw & 0x00FFFFFF;
			
			// Confronto risultati
			Serial.printf("API ESP-IDF: [%02X %02X %02X] = 0x%06X\n", 
						 rx_data[0], rx_data[1], rx_data[2], api_result);
			Serial.printf("Nativo raw:  0x%08X\n", native_raw);
			Serial.printf("Nativo mask: 0x%06X\n", native_result);
			
			// Test diverse interpretazioni del dato nativo
			uint32_t native_swap1 = ((native_raw & 0xFF) << 16) | 
								   (native_raw & 0xFF00) | 
								   ((native_raw & 0xFF0000) >> 16);
			
			uint32_t native_swap2 = __builtin_bswap32(native_raw) >> 8;
			
			uint32_t native_shift = native_raw >> 8;
			
			Serial.printf("Nativo swap1: 0x%06X\n", native_swap1 & 0xFFFFFF);
			Serial.printf("Nativo swap2: 0x%06X\n", native_swap2 & 0xFFFFFF);
			Serial.printf("Nativo shift: 0x%06X\n", native_shift & 0xFFFFFF);
			
			// Verifica quale coincide con API
			if ((api_result & 0xFFFFFF) == (native_result & 0xFFFFFF)) {
				Serial.println("✅ MATCH: Nativo mask");
			} else if ((api_result & 0xFFFFFF) == (native_swap1 & 0xFFFFFF)) {
				Serial.println("✅ MATCH: Nativo swap1");
			} else if ((api_result & 0xFFFFFF) == (native_swap2 & 0xFFFFFF)) {
				Serial.println("✅ MATCH: Nativo swap2");
			} else if ((api_result & 0xFFFFFF) == (native_shift & 0xFFFFFF)) {
				Serial.println("✅ MATCH: Nativo shift");
			} else {
				Serial.println("❌ NESSUN MATCH trovato");
			}
			
			delay(100);
		}
	}

	// 2. ANALISI BYTE ORDER
	void analyzeByteOrder() {
		Serial.println("\n=== ANALISI BYTE ORDER ===");
		
		// Test con un campione
		while (gpio_get_level((gpio_num_t)ADS1256_PIN_DRDY));
		
		spi_dev_t* SPI_DEV = &SPI2;
		SPI_DEV->data_buf[0] = 0;
		SPI_DEV->cmd.usr = 1;
		while (SPI_DEV->cmd.usr);
		
		uint32_t raw = SPI_DEV->data_buf[0];
		
		Serial.printf("Raw data_buf[0]: 0x%08X\n", raw);
		Serial.println("Analisi byte:");
		Serial.printf("  Byte 0 (LSB): 0x%02X\n", (raw >> 0) & 0xFF);
		Serial.printf("  Byte 1:       0x%02X\n", (raw >> 8) & 0xFF);
		Serial.printf("  Byte 2:       0x%02X\n", (raw >> 16) & 0xFF);
		Serial.printf("  Byte 3 (MSB): 0x%02X\n", (raw >> 24) & 0xFF);
		
		Serial.println("\nPossibili interpretazioni ADS1256 (MSB first):");
		
		// ADS1256 invia MSB first, ma ESP32 data_buf potrebbe memorizzare diversamente
		Serial.printf("1. Direct mask:     0x%06X\n", raw & 0xFFFFFF);
		Serial.printf("2. Shift right 8:   0x%06X\n", (raw >> 8) & 0xFFFFFF);
		Serial.printf("3. Byte swap:       0x%06X\n", 
					 (((raw & 0xFF) << 16) | (raw & 0xFF00) | ((raw >> 16) & 0xFF)) & 0xFFFFFF);
		Serial.printf("4. Full bswap>>8:   0x%06X\n", (__builtin_bswap32(raw) >> 8) & 0xFFFFFF);
	}

	// 3. TRASFERIMENTO SPI CORRETTO
	uint32_t IRAM_ATTR spi_transfer_24bit_corrected() {
		spi_dev_t* SPI_DEV = &SPI2;
		
		// Clear e transfer
		SPI_DEV->data_buf[0] = 0;
		SPI_DEV->cmd.usr = 1;
		while (SPI_DEV->cmd.usr);
		
		uint32_t raw = SPI_DEV->data_buf[0];
		
		// ✅ CORREZIONE: Test diverse interpretazioni
		// Basandoci sull'analisi, probabilmente serve:
		
		// Opzione A: Shift right 8 bit (se ESP32 memorizza con padding)
		uint32_t result_a = (raw >> 8) & 0x00FFFFFF;
		
		// Opzione B: Byte swap (se ordine bytes invertito)
		uint32_t result_b = ((raw & 0xFF) << 16) | 
						   (raw & 0xFF00) | 
						   ((raw & 0xFF0000) >> 16);
		result_b &= 0x00FFFFFF;
		
		// Opzione C: Full byte swap + shift
		uint32_t result_c = (__builtin_bswap32(raw) >> 8) & 0x00FFFFFF;
		
		// Per ora restituisci la più probabile (da determinare con compareDataFormats)
		return result_a;  // Cambia questo basandoti sui risultati del confronto
	}

	// 4. BATCH READING CORRETTO
	void read_data_batch_native_corrected(BatchData& batch, uint16_t samplesPerBatch, uint16_t decimationFactor = 1) {
		if (!isStreaming) return;
		
		batch.count = 0;
		batch.t = esp_timer_get_time();
		
		spi_dev_t* SPI_DEV = &SPI2;
		
		Serial.println("Lettura batch con formato dati corretto...");
		
		while (batch.count < samplesPerBatch && batch.count < MAX_SAMPLES_PER_BATCH) {
			if (!wait_drdy_fast(2000)) continue;
			
			// Trasferimento
			SPI_DEV->data_buf[0] = 0;
			SPI_DEV->cmd.usr = 1;
			while (SPI_DEV->cmd.usr);
			
			uint32_t raw = SPI_DEV->data_buf[0];
			
			// ✅ APPLICA CORREZIONE FORMATO (da determinare)
			uint32_t result = spi_transfer_24bit_corrected();
			
			// Debug primi campioni
			if (batch.count < 5) {
				Serial.printf("Campione %d: raw=0x%08X, corrected=0x%06X\n", 
							 batch.count, raw, result);
				
				// Mostra anche interpretazione come tensione
				int32_t signed_val = (result & 0x800000) ? (result | 0xFF000000) : result;
				float voltage = ((float)signed_val / 8388608.0f) * 2.5f;
				Serial.printf("  Tensione: %.6f V\n", voltage);
			}
			
			if (result != 0 && result != 0xFFFFFF) {
				if (result & 0x800000) result |= 0xFF000000;
				
				emaFilteredValue = emaAlpha * (float)result + (1.0f - emaAlpha) * emaFilteredValue;
				uint32_t output = (uint32_t)emaFilteredValue;
				
				batch.v[batch.count][0] = (output >> 16) & 0xFF;
				batch.v[batch.count][1] = (output >> 8) & 0xFF;
				batch.v[batch.count][2] = output & 0xFF;
				
				batch.count++;
			}
		}
		
		Serial.printf("Batch corretto: %d campioni\n", batch.count);
	}

	// 5. TEST COMPLETO FORMATO
	void testDataFormatFix() {
		Serial.println("\n=== TEST CORREZIONE FORMATO DATI ===");
		
		if (!isStreaming) {
			Serial.println("Avviando streaming...");
			//startStreamingConfigAfter();
			delay(100);
		}
		
		// Step 1: Confronto formati
		Serial.println("Step 1: Confronto API vs Nativo");
		compareDataFormats();
		
		// Step 2: Analisi dettagliata
		Serial.println("\nStep 2: Analisi byte order");
		analyzeByteOrder();
		
		// Step 3: Test batch corretto
		Serial.println("\nStep 3: Test batch con formato corretto");
		BatchData corrected_batch;
		read_data_batch_native_corrected(corrected_batch, 10);
		
		Serial.println("\n✅ Ora dovresti vedere dati sensati!");
	}

	// ============================================================================
	// DICHIARAZIONI DA AGGIUNGERE NEL .h (sezione public o private)
	// ============================================================================
	/*
	void compareDataFormats();
	void analyzeByteOrder();
	uint32_t spi_transfer_24bit_corrected();
	void read_data_batch_native_corrected(BatchData& batch, uint16_t samplesPerBatch, uint16_t decimationFactor = 1);
	void testDataFormatFix();
	*/

	// ============================================================================
	// COME USARE NEL LOOP():
	// ============================================================================
	/*
	void loop() {
		static bool testDone = false;
		
		if (!testDone) {
			ads1256.testDataFormatFix();  // Se ads1256 è il nome del tuo oggetto
			testDone = true;
		}
		
		delay(1000);
	}
	*/
    
private:
    static spi_device_handle_t spi;  // handle SPI statico
    //static spi_transaction_t tr;       // Variabile globale per le transazioni
    uint64_t emaFilteredValue;
    float emaAlpha = 0.1f;
    static bool isStreaming;  //  // flag statico per tracciare lo stato dello streaming
    static bool spi_initialized;  // flag statico
    static bool resetInProgress;  // flag statico
    static SemaphoreHandle_t spi_bus_mutex;
	static char hex_table[256][2];
    uint8_t dma_buffer[32];
    // Test signal configuration
    bool testSignalEnabled;
    float testSignalTime = 0;
    float testFrequency = 1.0f;     // Hz
    float baseAmplitude = 1.25f;    // V (metà di 2.5V)
    float amFrequency = 0.1f;       // Hz
    const float vRef = 2.5f;        // Tensione di riferimento ADS1256
    float rampValue = 0.0f;  // Valore della rampa mantenuto tra i batch
    uint32_t offset = 0;
    ADS1256_ErrorHandler errorHandler;


    void wakeup(void) {
        sendCommand(ADS1256_CMD_WAKEUP);
    }

    void reset(void) {
        sendCommand(ADS1256_CMD_RESET);
    }

    bool sendCommand(uint8_t cmd) {
        if (!spi_initialized) return false;
        CSON();
        
        // Comandi che non richiedono DRDY
        if (cmd != ADS1256_CMD_SYNC && 
            cmd != ADS1256_CMD_RESET && 
            cmd != ADS1256_CMD_SDATAC &&
            cmd != ADS1256_CMD_SELFCAL &&  // Aggiunto SELFCAL
            cmd != ADS1256_CMD_RDATAC) {   // Aggiunto RDATAC
            waitDRDY();
        }


        spi_transaction_t t = {};
        t.length = 8;
        t.tx_buffer = &cmd;
        spi_device_transmit(spi, &t);
        
        if (cmd == ADS1256_CMD_RESET) {
            T11Delay();
        }
        T3Delay();
        CSOFF();
        return true;
    }

    static void sendCommand_static(uint8_t cmd) {
        if (!spi_initialized) return;
        
        // Comandi che non richiedono DRDY
        if (cmd != ADS1256_CMD_SYNC && 
            cmd != ADS1256_CMD_RESET && 
            cmd != ADS1256_CMD_SDATAC) {
            waitDRDY_static();
        }
        
        CSON_static();
        T2Delay();
        
        spi_transaction_t t = {};
        t.length = 8;
        t.tx_buffer = &cmd;
        spi_device_transmit(spi, &t);
        
        T6Delay();
        
        if (cmd == ADS1256_CMD_RESET) {
            T11Delay();
        }
        
        T3Delay();
        CSOFF_static();
    }

    uint8_t readRegister(uint8_t reg) {
        if(reg > ADS1256_REG_FSC2) return 0;
        if(!spi_initialized) return 0;

        bool was_streaming = isStreaming;
        if(was_streaming) {
            sendCommand(ADS1256_CMD_SDATAC);
            isStreaming = false;
        }
        
        CSON();
        waitDRDY();
        
        // Invia comando RREG + registro
        uint8_t cmd = ADS1256_CMD_RREG | reg;
        spi_transaction_t t1 = {};
        t1.length = 8;
        t1.tx_buffer = &cmd;
        spi_device_transmit(spi, &t1);
        T6Delay();
        
        // Invia count byte
        uint8_t count = 0x00;
        spi_transaction_t t2 = {};
        t2.length = 8;
        t2.tx_buffer = &count;
        spi_device_transmit(spi, &t2);
        T6Delay();
        
        // Leggi valore
        uint8_t value = 0;
        spi_transaction_t t3 = {};
        t3.length = 8;
        t3.rx_buffer = &value;
        spi_device_transmit(spi, &t3);
        T6Delay();
        
        CSOFF();

        if(was_streaming) {
            sendCommand(ADS1256_CMD_RDATAC);
            isStreaming = true;
        }
        
        return value;
    }

    /*
    le transazioni SPI in byte singoli invece di fare un'unica transazione di 24 bit. 
    Questo permette una temporizzazione più precisa tra i byte come richiesto 
    dal protocollo dell'ADS1256.

    La sequenza funzionante è:
    - WREG (byte 1)
    - Count (byte 2)
    - Value (byte 3)

    Con delay T6 tra ogni byte.
    Lo stesso vale per la lettura:
    - RREG (byte 1)
    - Count (byte 2)
    - Read value (byte 3)
    */

    bool writeRegister(uint8_t reg, uint8_t value) {
        if(reg > ADS1256_REG_FSC2) return false;
        if(!spi_initialized) return false;
       
        CSON();
        waitDRDY();

        // Prima transazione: WREG
        uint8_t wreg = ADS1256_CMD_WREG | reg;
        spi_transaction_t t1 = {};
        t1.length = 8;
        t1.tx_buffer = &wreg;
        spi_device_transmit(spi, &t1);
        Serial.printf("WREG sent: 0x%02X\n", wreg);
        T6Delay();

        // Seconda transazione: count
        uint8_t count = 0x00;
        spi_transaction_t t2 = {};
        t2.length = 8;
        t2.tx_buffer = &count;
        spi_device_transmit(spi, &t2);
        Serial.println("Count sent");
        T6Delay();

        // Terza transazione: value
        spi_transaction_t t3 = {};
        t3.length = 8;
        t3.tx_buffer = &value;
        spi_device_transmit(spi, &t3);
        Serial.printf("writeRegister: Value sent: 0x%02X\n", value);
        
        T3Delay();
        CSOFF();

        delay(1);  // Delay prima della verifica

        // Verifica
        uint8_t readback = readRegister(reg);
        Serial.printf("writeRegister: Write: 0x%02X, Read: 0x%02X\n", value, readback);
        
        // Qui aggiungiamo il check speciale per STATUS
        if(reg == ADS1256_REG_STATUS) {
            // Per STATUS verifichiamo solo i bit che abbiamo scritto
            return (readback & 0x07) == (value & 0x07);  // Verifica solo i 3 bit bassi
        }

        return (readback == value);
    }

    inline void CSON() {
        gpio_set_level((gpio_num_t)ADS1256_PIN_CS, 0);
        //digitalWrite(ADS1256_PIN_CS, LOW);  // CS attivo basso
        T2Delay();  // Delay dopo CS basso
    }
	
	inline void CSON_no_delay() {
        gpio_set_level((gpio_num_t)ADS1256_PIN_CS, 0);
        //digitalWrite(ADS1256_PIN_CS, LOW);  // CS attivo basso
        //T2Delay();  // Delay dopo CS basso
    }

    inline void CSOFF() {
        T3Delay();  // Delay prima di CS alto
        //digitalWrite(ADS1256_PIN_CS, HIGH); // CS inattivo alto
        gpio_set_level((gpio_num_t)ADS1256_PIN_CS, 1);
    }
/*
    void CSON(){
        gpio_set_level((gpio_num_t)ADS1256_PIN_CS, 0);
    }

    void CSOFF(){
        gpio_set_level((gpio_num_t)ADS1256_PIN_CS, 1);
    }
    */
/*
    // Timing functions for ADS1256

    // t1 - Tempo minimo CS basso (100ns)
    void T1Delay() {
        delayMicroseconds(1);  // Arduino non può fare delay di ns, usiamo 1us
    }

    // t2 - Setup CS al primo SCLK (50ns)
    void T2Delay() {
        delayMicroseconds(1);  // Minimo delay possibile
    }

    // t3 - Hold ultimo SCLK a CS alto (50ns)
    void T3Delay() {
        delayMicroseconds(1);  // Minimo delay possibile
    }

    // t4 - Disabilitazione CS (50ns)
    void T4Delay() {
        delayMicroseconds(1);  // Minimo delay possibile
    }

    // t5 - Setup DRDY dopo SYNC (24 * 1/7.68MHz = ~3.125us)
    void T5Delay() {
        delayMicroseconds(4);  // Arrotondato per sicurezza
    }

    // t6 - Setup DRDY dopo lettura (50ns)
    void T6Delay() {
        delayMicroseconds(1);  // Minimo delay possibile
    }

    // t11 - Power-on reset (25ms)
    void T11Delay() {
        delay(25);  // 25 millisecondi
    }

    // tSETTLE - Tempo di settling dopo cambio canale/guadagno
    // Dipende dal data rate. Per 30000 SPS:
    void TSettleDelay() {
        delayMicroseconds(400);  // Tipicamente 3-4 volte il periodo di conversione
    }
*/
    // Funzione helper per attendere che DRDY diventi basso
    void waitDRDY() {
        for(uint16_t i = 0; gpio_get_level((gpio_num_t)ADS1256_PIN_DRDY) && i < 2000; i++) {
            __asm__ __volatile__ ("nop\n\t"
                            "nop\n\t"
                            "nop\n\t" ::);
        }
    }
	
	void waitDRDYHigh() {
        for(uint16_t i = 0; gpio_get_level((gpio_num_t)ADS1256_PIN_DRDY) == 0 && i < 1000; i++) {
            __asm__ __volatile__ ("nop\n\t"
                            "nop\n\t"
                            "nop\n\t" ::);
        }
    }

    static void waitDRDY_static() {
        for(uint16_t i = 0; gpio_get_level((gpio_num_t)ADS1256_PIN_DRDY) && i < 2000; i++) {
            __asm__ __volatile__ ("nop\n\t"
                            "nop\n\t"
                            "nop\n\t" ::);
        }
    }

    bool waitDRDY(uint32_t timeout) {
        uint32_t startTime = millis();        
        while(gpio_get_level((gpio_num_t)ADS1256_PIN_DRDY)) {
            if(millis() - startTime > timeout) {
                errorHandler.setError(ADS1256_Error::DRDY_TIMEOUT, 
                    "DRDY timeout waiting");
                return false; // Timeout della calibrazione
            }
            delay(1);
        }
        return true;
    }
	
	inline void T3uDelay() {
		ets_delay_us(3); // su ESP32, delay minima ~1 µs
	}


    /*
    La funzione sync() è necessaria per l'ADS1256. Dal datasheet, il comando SYNC serve a:
    - Sincronizzare l'inizio di una conversione A/D
    - Far uscire il chip dallo standby o dalla modalità auto-calibrazione
    - Riavviare il modulatore sigma-delta

    È particolarmente importante dopo:
    - Cambio del canale di input (set_channel)
    - Modifica del gain (set_gain)
    - Modifica di altri parametri di configurazione

    La sequenza tipica è:
    - Scrittura registro 
    - SYNC
    - WAKEUP (opzionale)
    */
    void sync(void) {
        sendCommand(ADS1256_CMD_SYNC);
    }
	
	bool init_hex_lookup_table_safe() {
		static bool initialized = false;
		
		if (initialized) return true;  // Già inizializzata
		
		// Verifica che abbiamo memoria sufficiente
		if (sizeof(hex_table) < 512) {
			return false;  // Errore: memoria insufficiente
		}
		
		// Inizializza la lookup table
		const char* hex_chars = "0123456789abcdef";
		
		for (int i = 0; i < 256; i++) {
			int high_nibble = (i >> 4) & 0xF;  // 4 bit alti
			int low_nibble = i & 0xF;          // 4 bit bassi
			
			hex_table[i][0] = hex_chars[high_nibble];
			hex_table[i][1] = hex_chars[low_nibble];
		}
		
		initialized = true;
		return true;  // Successo
	}

	// ====================================================================
	// FUNZIONE DI TEST/VERIFICA (opzionale)
	// ====================================================================

	bool verify_hex_lookup_table() {
		// Test alcuni valori per verificare correttezza
		if (hex_table[0][0] != '0' || hex_table[0][1] != '0') return false;        // 0x00 → "00"
		if (hex_table[15][0] != '0' || hex_table[15][1] != 'f') return false;      // 0x0F → "0f" 
		if (hex_table[16][0] != '1' || hex_table[16][1] != '0') return false;      // 0x10 → "10"
		if (hex_table[171][0] != 'a' || hex_table[171][1] != 'b') return false;    // 0xAB → "ab"
		if (hex_table[255][0] != 'f' || hex_table[255][1] != 'f') return false;    // 0xFF → "ff"
		
		return true;  // Tutti i test passati
	}
	
	
	// ========== ASSEMBLY INLINE PER PORZIONI CRITICHE ==========

	// ASM per conversione timestamp ultra-veloce usando la TUA hex_table esistente
	static inline void convert_timestamp_asm(uint64_t timestamp, char* buffer, uint8_t nibbles) {
		// Fallback C ultra-ottimizzato usando la tua hex_table esistente
		static const char hex_chars[16] = {'0','1','2','3','4','5','6','7','8','9','a','b','c','d','e','f'};
		
		// Converti da destra a sinistra (MSB first)
		for (int i = nibbles - 1; i >= 0; i--) {
			uint8_t nibble = (timestamp >> (i * 4)) & 0xF;
			buffer[nibbles - 1 - i] = hex_chars[nibble];
		}
	}

	// ASM per conversione hex sample usando la TUA hex_table esistente
	static inline void convert_hex_sample_asm(uint32_t sample, char* output) {
		// Usa direttamente la tua hex_table con word access ottimizzato
		register uint8_t b0 = (sample >> 16) & 0xFF;
		register uint8_t b1 = (sample >> 8) & 0xFF;
		register uint8_t b2 = sample & 0xFF;
		
		// Word copy dalla tua hex_table (2 char per volta)
		*((uint16_t*)output) = *((uint16_t*)&hex_table[b0][0]);     // byte 0 -> 2 char
		*((uint16_t*)(output+2)) = *((uint16_t*)&hex_table[b1][0]); // byte 1 -> 2 char  
		*((uint16_t*)(output+4)) = *((uint16_t*)&hex_table[b2][0]); // byte 2 -> 2 char
	}
	
	// ========== OTTIMIZZAZIONI AGGIUNTIVE CON ASM ==========

	// ASM per copia memory ultra-veloce
	static inline void fast_memcpy_asm(void* dst, const void* src, size_t len) {
		if (len >= 16 && ((uintptr_t)dst & 3) == 0 && ((uintptr_t)src & 3) == 0) {
			// Aligned copy con word transfer
			asm volatile (
				"mov.n a2, %0\n"           // dst
				"mov.n a3, %1\n"           // src  
				"mov.n a4, %2\n"           // len
				"srli a4, a4, 2\n"         // len /= 4 (word count)
				
				"copy_loop:\n"
				"l32i a5, a3, 0\n"         // carica word da src
				"s32i a5, a2, 0\n"         // salva word in dst
				"addi.n a2, a2, 4\n"       // dst += 4
				"addi.n a3, a3, 4\n"       // src += 4
				"addi a4, a4, -1\n"        // count--
				"bnez a4, copy_loop\n"
				:
				: "r" (dst), "r" (src), "r" (len)
				: "a2", "a3", "a4", "a5", "memory"
			);
		} else {
			memcpy(dst, src, len);  // Fallback
		}
	}

	// ASM per checksum/validation ultra-veloce
	static inline uint32_t fast_checksum_asm(const char* data, size_t len) {
		uint32_t checksum = 0;
		asm volatile (
			"mov.n a2, %1\n"           // data pointer
			"mov.n a3, %2\n"           // length
			"movi.n a4, 0\n"           // checksum = 0
			"srli a3, a3, 2\n"         // len /= 4
			
			"checksum_loop:\n"
			"l32i a5, a2, 0\n"         // carica 4 byte
			"add a4, a4, a5\n"         // accumula
			"addi.n a2, a2, 4\n"       // avanza pointer
			"addi a3, a3, -1\n"        // decrementa counter
			"bnez a3, checksum_loop\n"
			
			"mov.n %0, a4\n"           // result
			: "=r" (checksum)
			: "r" (data), "r" (len)
			: "a2", "a3", "a4", "a5"
		);
		return checksum;
	}

	// ========== MACRO PER OTTIMIZZAZIONI COMPILE-TIME ==========
	#define LIKELY(x)       __builtin_expect(!!(x), 1)
	#define UNLIKELY(x)     __builtin_expect(!!(x), 0)
	#define INLINE          __attribute__((always_inline)) inline
	#define HOT_FUNCTION    __attribute__((hot))
	#define COLD_FUNCTION   __attribute__((cold))

	// Funzione wrapper ottimizzata SENZA lookup table aggiuntive
	HOT_FUNCTION 
	int read_data_json_optimized_safe(char* jsonBuf, int maxJsonLen, uint16_t samplesPerBatch, uint16_t decimationFactor = 1) {
		// Prefetch solo della TUA hex_table esistente
		__builtin_prefetch(hex_table, 0, 3);
		
		if (UNLIKELY(!isStreaming || !jsonBuf)) return -1;
		
		return read_data_json_fir(jsonBuf, maxJsonLen, samplesPerBatch, decimationFactor);
	}
};

// Definizione del flag statico
bool ADS1256_DMA::spi_initialized = false;
bool ADS1256_DMA::resetInProgress = false;
bool ADS1256_DMA::isStreaming = false;
spi_device_handle_t ADS1256_DMA::spi = nullptr;
SemaphoreHandle_t ADS1256_DMA::spi_bus_mutex = nullptr;
char ADS1256_DMA::hex_table[256][2];
//spi_transaction_t ADS1256_DMA::tr = {};  // Inizializzazione della tr statica
#endif
