marconicivitavecchia/2024-pedana-salto/(commit log)

2025-06-26 Add files via upload
    Analizzando il tuo codice, il problema è molto chiaro: **il ring buffer viene creato troppo tardi nel processo di inizializzazione**, causando l'assertion failure perché l'ADC task cerca di usarlo prima che sia completamente inizializzato.
    ## Il problema principale:
    L'ADC task (`adcTask`) viene avviato **prima** che il ring buffer (`batchQueue`) sia creato:
    ```cpp
    void setup() {
    // ... inizializzazioni ...
    // ADC task viene avviato QUI
    adcMonitor = new TaskMonitor(...);
    adcMonitor->startTask(); // ← ADC task inizia SUBITO
    Serial.println("Setup completato");
    // Ma batchQueue viene creato solo in check_heap_usage()
    // che viene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
    [adcstraemer.ino]
2025-06-27 Add files via upload
    adesso genera 150 campioni invece di 149
